Hennnnnnryyyy/StepperController/README.md

# StepperController
A simple handheld stepper controller
