Hennnnnnryyyy/StepperController/Firmware/Stepper_Firmware/Readme.txt

Just open Stepper_Firmware.ino in Arduino IDE. 
Compile it for ESP32S3 Dev Module

Make sure you have the following libraries:
Adafruit_GFX
Adafruit_SSD1305
AccelStepper
TMCStepper
