Hennnnnnryyyy/StepperController/Business Plan.docx

# Summary

Product: Handheld stepper motor controller with knob, buttons, screen; instant jog/reciprocate/constant-speed without writing firmware.

SKUs & MSRP: Base $49; Battery version $89.

Launch path: Kickstarter → Amazon FBA + DTC site, with YouTube dev logs and creator plugs.

Positioning: “The fastest way to move a stepper for debugging and setup—no code, no laptop.”

$28.60 gross/unit; $20.40 net/unit after CAC/ops; break-even 589 units; $90k EBITA @ 5k units, $192k @ 10k.

# Problem → Solution

Problem: Debugging steppers sucks: wiring an MCU, driver, and writing throwaway code just to jog a motor.

Solution: Pocket tool that powers/controls a stepper directly (or via common drivers), with preset modes: jog, constant RPM, reciprocate.

# Product & Roadmap

Base ($49): Controller, USB-C PD, power adapter not included.

Battery ($89): Integrated cell; same UI plus on-the-go use.

Roadmap: Multi-axis, MicroPLC

# Market & Customers

Primary: 3D-printing & CNC hobbyists, R&D labs, robotics teams, test/fixture techs, hardware educators.

Buying triggers: new printer/CNC builds, prototype build involving steppers, prototype testing, troubleshooting jams/skips, fixture bring-up, classroom labs.

# Competitive context

Direct: DIY Arduino + driver; GRBL jog pendants (require controller/firmware); dev boards (uStepper/Mechaduino variants).

Our wedge: zero setup, handheld, purpose-built debugging workflows.

# Go-to-Market

Kickstarter (30–45 days)

Goal: Validate demand + fund tooling/PVT.

Tiers: $44 early bird, $49 regular, $89 battery, 2/3-packs.

Traffic plan: Own YT channel + 5–10 creator plugs; Reddit/Hackaday/Hackster posts; email waitlist.

Post-KS Retail

Amazon FBA: Target 50+ reviews by month 3; keywords around “stepper tester / jog pendant / NEMA17 controller”.

DTC: Simple landing page with demo video and order page; support link & tutorials.

Content cadence: 1 long dev video + 3–5 shorts per month; creator UGC reused as ads.

# Funnel & unit ranges

Assumptions (base):

KS: YT view→click 1.5%; KS page conv 5%; 1.2 units/backer.

Post KS: YT view→click 1%; Amazon page conv 5%; 1.2 units/backer.

Kickstarter units = 297

First year retail = 363

First year total = 660

Optimistic:

Kickstarter units = 3303

First year retail = 4579

First year total = 7579

# Pricing & Unit Economics (non-battery version)

Assumptions: Amazon FBA, referral fee 8% (Consumer Electronics), Trump 40%, heavy social focus CAC.

Ex-Works (China): $8.08

BoM $6.20 • Scrap 3% $0.24 • Direct labor (1.5 min) $0.14 • CM profit $1.00 • Packaging $0.50

Landed Cost (to Amazon): $13.76

Ocean + drayage $2.00 • Tariff 40% $3.14 • Customs/broker/ISF $0.15 • Inbound to Amazon $0.40

Amazon variable fees:

FBA fulfillment $3.43 • Referral (8%) ~$4.00 • Amazon return handling $0.20

Total cost after Amazon fees: $21.39

Unit margins @ $49.99:

Gross profit per unit: $28.60

Below-the-line per-unit: CAC $5.00 • Customer support $0.50 • Inventory financing $1.10 • Returns loss $0.50 • Overhead $1.10

Profit per unit: $20.40

# Financials Summary

Fixed costs: Product liability $1,000, Tooling/fixtures/overhead $10,000, Company overhead $1,000 → Total: $12,000

EBITA by volume (after fixed costs):

Break-even: ~589 units

1,000 units: $8,396.87

2,000 units: $28,793.74

5,000 units: $89,984.35

10,000 units: $191,968.70

# Operations & Timeline (EVT→DVT→PVT)

Now–T0: DFM, finalize schematics/firmware; confirm drivers supported; enclosure tweaks.

T0+4–6 wks: EVT prototypes; bench testing with NEMA 17/23; HAL/EMI pre-checks.

T0+12-16 wks: DVT; pilot run; packaging; KS campaign asset creation.

KS month: 30 days live.

Post-KS (8–12 wks): PVT; ship backer orders; switch listing to Amazon/DTC.

Compliance (can skip for KS):

Base SKU: FCC/CE (unintentional radiator), RoHS.

Battery SKU: UN38.3, MSDS, FBA hazmat eligibility; separate packaging + labeling.

# Key risks & mitigations

Battery logistics (FBA hazmat): start with base SKU first; launch battery on DTC if FBA hazmat queues are slow.

Tariffs/HTS: confirm code; 25% swings landed cost.

Conversion risk: preload reviews via KS backers + Vine; ship with insert card (QR to setup video).

Return rate: target <5% via clear “works with X/Y/Z” compatibility table and wiring diagram.
