Hennnnnnryyyy/StepperController/Money Estimates.xlsx

Sheet: Market Estimation
 | Conservative | Base | Optimistic
KS, 30 days:
YT Viewcount | 50000 | 300000 | 1000000
Other sources (search etc.) | 5000 | 30000 | 100000
YT -> KS funnel | 0.50% | 1.50% | 3.00%
KS conversion | 3% | 5% | 7%
Units per customer | 1.15 | 1.2 | 1.3
Units sold | 9.4875 | 297 | 3003
Post KS
Monthy YT view | 15000 | 50000 | 100000
Other sources (search etc.) | 1500 | 5000 | 100000
YT -> Amazon funnel | 0.30% | 1% | 2%
Product page conversion | 2% | 5% | 8%
Units per customer | 1.15 | 1.2 | 1.3
 | 1.1385 | 33 | 416
First year | 22.011 | 660 | 7579

Sheet: Cost & PL Estimation
Current PCB Design |  |  |  |  |  | Current Pricing |  | Costdown Pricing
Index | Role/Category | Comment | Description | Designator | Quantity | Price @1k | Total @1k | Costdown | Cost down@1k | Total | Notes
25 | Resistors | 10.2k | RES 23.2K OHM 0.5% 1/10W 0603 | R1 | 1 | $0.0005 | $0.001 |  |  | $0.001
26 |  | 470R | RES 23.2K OHM 0.5% 1/10W 0603 | R2 | 1 | $0.0005 | $0.001 |  |  | $0.001
27 |  | 3.9k | RES 23.2K OHM 0.5% 1/10W 0603 | R3 | 1 | $0.0005 | $0.001 |  |  | $0.001
28 |  | 10.5k | RES 23.2K OHM 0.5% 1/10W 0603 | R4 | 1 | $0.0005 | $0.001 |  |  | $0.001
29 |  | 33k | RES 23.2K OHM 0.5% 1/10W 0603 | R5 | 1 | $0.0005 | $0.001 |  |  | $0.001
30 |  | 3.24k | RES 23.2K OHM 0.5% 1/10W 0603 | R6 | 1 | $0.0005 | $0.001 |  |  | $0.001
31 |  | 10k | RES 1% 0603 | R7, R8, R13, R14, R17, R18, R19 | 7 | $0.0005 | $0.004 |  |  | $0.004
32 |  | 47R | RES 1% 0603 | R9, R10, R11, R22, R24, R26, R28, R30, R32, R33, R34 | 11 | $0.0005 | $0.005 |  |  | $0.005
33 |  | 910k | RES 1% 0603 | R12 | 1 | $0.0005 | $0.001 |  |  | $0.001
34 |  | 1k | RES 1% 0603 | R15, R16, R23, R25, R27, R29, R31, R35, R36, R37 | 10 | $0.0005 | $0.005 |  |  | $0.005
35 |  | 100m | C25334 | R20, R21 | 2 | $0.0025 | $0.005 |  |  | $0.005
0 | Capacitors | 100nF | C14663, CAP CER 0.022UF 25V X7R 0603 | C1, C4, C6, C14, C15, C18, C19, C22, C24, C25, C27, C28, C32, C33, C34, C35, C36, C37, C38, C39, C40, C42 | 22 | $0.0014 | $0.03 |  |  | $0.03
1 |  | 22uF | C12891 | C2, C3 | 2 | $0.0270 | $0.05 |  |  | $0.05
2 |  | 1uF | CAP CER 0.022UF 25V X7R 0603, C15849 | C5, C13, C16, C20 | 4 | $0.0027 | $0.01 |  |  | $0.01
3 |  | 10uF | C13585, C89632 | C7, C8, C12, C21, C23 | 5 | $0.0189 | $0.09 |  |  | $0.09
4 |  | 8.2nF |  | C9 | 1 | $0.0108 | $0.01 |  |  | $0.01
5 |  | 10pF |  | C10 | 1 | $0.0108 | $0.01 |  |  | $0.01
6 |  | 3.3nF |  | C11 | 1 | $0.0108 | $0.01 |  |  | $0.01
7 |  | 4.7uF | C29823 | C17 | 1 | $0.0197 | $0.02 |  |  | $0.02
8 |  | 100uF | C445063 | C29, C41 | 2 | $0.1334 | $0.27 | VEJ101M1HTR-0810 | $0.0508 | $0.10 | Cheap caps but not the worst caps
9 |  | 22nF | C21122 | C30 | 1 | $0.0025 | $0.0025 |  |  | $0.0025
10 |  | 2.2uF | C23630 | C31 | 1 | $0.0033 | $0.0033 |  |  | $0.0033
15 | Signals Out Terminal | Black | C430602 | E2 | 1 | $0.1648 | $0.16 |  | $0.0000 | $0.00 | Only one terminal set
20 | USB Conn. for Programming | 670688000 | Connector | J3 | 1 | $0.6645 | $0.66 |  | $0.0000 | $0.00 | No USB programming
39 | USB - UART converter | CP2102-GMR | Single-Chip USB to URAT Bridge, 3.3 V, -40 to 85 degC, 28-Pin QFN, RoHS, Tape and Reel | U3 | 1 | $1.2990 | $1.30 |  | $0.0000 | $0.00 | No USB programming
13 | Indicator | RED LED | 0603 LED | DS1 | 1 | $0.0107 | $0.01 |  |  | $0.01
24 | USB-UART reset transistors | MMBT5551LT1G | C41095 | Q1, Q2 | 2 | $0.0108 | $0.02 |  | $0.0000 | $0.00
23 | Other Motor Plugs | 22-27-2041 | C504991 | P1, P2 | 2 | $0.2560 | $0.51 | C22438287 | $0.0111 | $0.02
18 | DC Power Jack | DC-005-5A-2.0-SMT | C319134 | J1 | 1 | $0.2325 | $0.23 | USB-C | $0.0300 | $0.03 |  | https://www.lcsc.com/product-image/C29780875.html
17 | MCU | ESP32-S3-WROOM-1 | Integrated Circuit | IC1 | 1 | $3.4500 | $3.45 | STM32F030C6T6TR | $0.3645 | $0.36 | Not decided, just placeholder MCU | https://www.lcsc.com/product-detail/C106925.html?s_z=n_STM32F030C6T6TR
11 | Protection Diode | SS54 | SS54 | D1 | 1 | $0.0359 | $0.04 |  |  | $0.04
22 | Inductor | 22uH | C2651173 | L1 | 1 | $0.0483 | $0.05 |  |  | $0.05
19 | OLED Flex Connector | AFC07-S24ECA-00 | C262643 | J2 | 1 | $0.0569 | $0.06 |  |  | $0.06
38 | 12V Regulator for OLED | LM317AG-TN3-R | C75510 | U2 | 1 | $0.0912 | $0.09 |  |  | $0.09
37 | 3v3 Regulator | TPS54231DR | Buck Step Down Regulator with 3.5 to 28 V Input and 0.8 to 25 V Output, -40 to 150 degC, 8-Pin SOIC (D), Green (RoHS & no Sb/Br) | U1 | 1 | $0.1130 | $0.11 |  |  | $0.11
12 | TVS Diodes | 3V | C12756 | D2, D3, D4 | 3 | $0.0402 | $0.12 |  |  | $0.12
36 | Buttons | C255812 | SWITCH TACTILE SPST-NO 0.05A 24V | SW1, SW2, SW3, SW4, SW5, SW6, SW7 | 7 | $0.0201 | $0.14 |  |  | $0.14
14 | Power Out Terminals | Orange | C430604 | E1 | 1 | $0.1494 | $0.15 |  |  | $0.15
40 | Stepper Driver IC | TMC2209-LA | C465949 | U4 | 1 | $1.4535 | $1.45 | Custom | $0.2000 | $0.20 | Cost down stepper driver with external FETs
16 | Rotary Encoder | PEC11L-4115F-S0020 | ROTARY ENCODER MECHANICAL 20PPR | ENC1 | 1 | $2.0000 | $2.00 |  | $0.4000 | $0.40 | Costdown encoder
21 | Motor Spring Connections | XY115A-5.0-2P | C784935 | J4, J5 | 2 | $0.2114 | $0.42 |  | $0.0700 | $0.14 | Different connector | https://www.lcsc.com/product-image/C5349564.html
41 |  | PCB Substrate 120x70 |  |  | 1 | $0.4270 | $0.43 |  |  | $0.43
 |  | PCB Assembly Cost |  |  | 1 | $2.0000 | $2.00 |  |  | $1.00 | Guess
 |  | OLED |  |  | 1 | $7.0000 | $7.00 |  | $1.8000 | $1.80 | OLED doesn't seem to be affected by MOQ too much. $2 LCD
 |  | Shell | 36 grams ABS |  | 1 | $0.6000 | $0.60 |  |  | $0.60
 |  | Knob | 3gram ABS |  | 1 | $0.1000 | $0.10 |  |  | $0.10
 |  | BoM total |  |  |  |  | $21.65 |  |  | $6.22
 |  | Scrap | 3% |  |  |  |  |  |  | $0.24
 |  | Direct labor | 1.5 min assembly, test, box |  |  |  |  |  |  | $0.14
 |  | CM profit |  |  |  |  |  |  |  | $1.00
 |  | Packaging | Box |  | 1 | $0.5000 | $0.50 |  |  | $0.50
 |  | Ex-Works |  |  |  |  |  |  |  | $8.10
 |  | Ocean frieght + domistic drayage |  |  |  |  |  |  |  | $2.00
 |  | Trump | 40% |  |  |  |  |  |  | $3.15
 |  | Customs fees, brokerage, ISF |  |  |  |  |  |  |  | $0.15
 |  | Inbound to Amazon |  |  |  |  |  |  |  | $0.40
 |  | Landed cost |  |  |  |  |  |  |  | $13.80
 |  | FBA fulfilment |  |  |  |  |  |  |  | $3.43 | Simlar rates for KS
 |  | Referral Fee (consumer electronics) | 8% sell price, absorbs credit card fees here |  |  |  |  |  |  | $4.00
 |  | Returns |  |  |  |  |  |  |  | $0.20
 |  | Total Cost after Amazon Fees |  |  |  |  |  |  |  | $21.43
 |  | Retail price (set here) |  |  |  |  |  |  |  | $49.99
 |  | Gross profit per unit |  |  |  |  |  |  |  | $28.56
 |  | CAC/unit | Marketing, sample units, heavy social media focus |  |  |  |  |  |  | -$5.00
 |  | Customer service | Discord moderator |  |  |  |  |  |  | -$0.50
 |  | Inventory |  |  |  |  |  |  |  | -$1.10
 |  | Returns |  |  |  |  |  |  |  | -$0.50
 |  | Overhead |  |  |  |  |  |  |  | -$1.10
 |  | Net profit per unit |  |  |  |  |  |  |  | $20.36
 |  | Fixed costs
 |  | Product liability insurance |  |  |  |  |  |  |  | -$1000.00
 |  | Tool cost + setup fees + overhead (conservative) |  |  |  |  |  |  |  | -$10000.00
 |  | Company overhead |  |  |  |  |  |  |  | -$1000.00
 |  | Total fixed costs |  |  |  |  |  |  |  | -$12000.00
 |  |  |  |  |  |  |  |  | Units sold | EBITA
 |  |  |  |  |  |  |  |  | 589 | -$6.49
 |  |  |  |  |  |  |  |  | 1000 | $8362.50
 |  |  |  |  |  |  |  |  | 2000 | $28725.00
 |  |  |  |  |  |  |  |  | 5000 | $89812.50
 |  |  |  |  |  |  |  |  | 10000 | $191625.00
 |  |  |  |  |  |  |  |  | 20000 | $395250.00
 |  |  |  |  |  |  |  |  | 50773 | $1021865.21
