Hennnnnnryyyy/StepperController/CAD/Housing.step

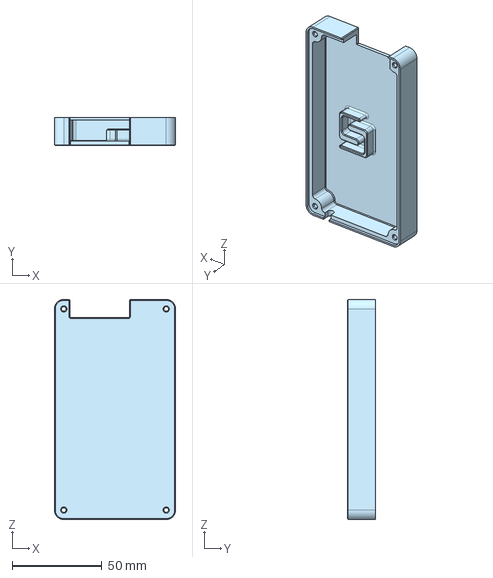
[picture p1: CAD file, 2025-09-03]
CAD/Housing.step
67.5 x 15.8 x 122.5 mm
