Hennnnnnryyyy/StepperController/PCB/KiCAD/Library Files/EC12D1524403/3D/EC12D1524403.stp

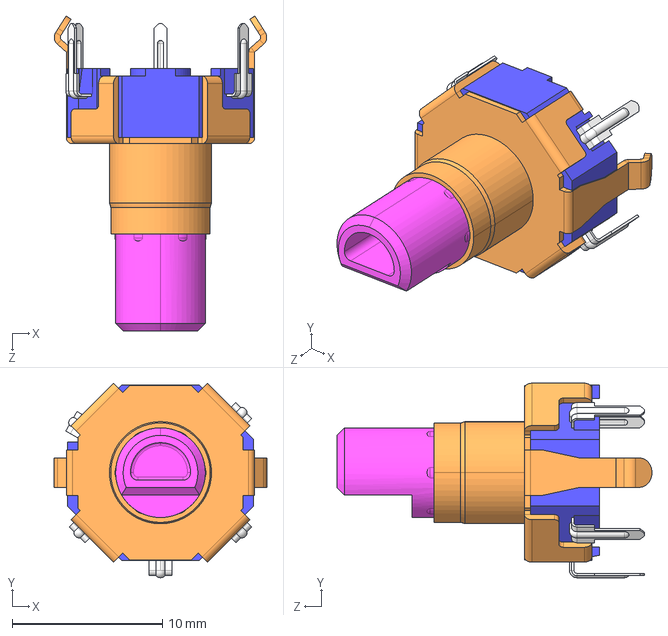
[picture p2: CAD file, 2025-09-03]
PCB/KiCAD/Library Files/EC12D1524403/3D/EC12D1524403.stp
14.1 x 13.0 x 21.0 mm
