Hennnnnnryyyy/StepperController/CAD/Knob.step

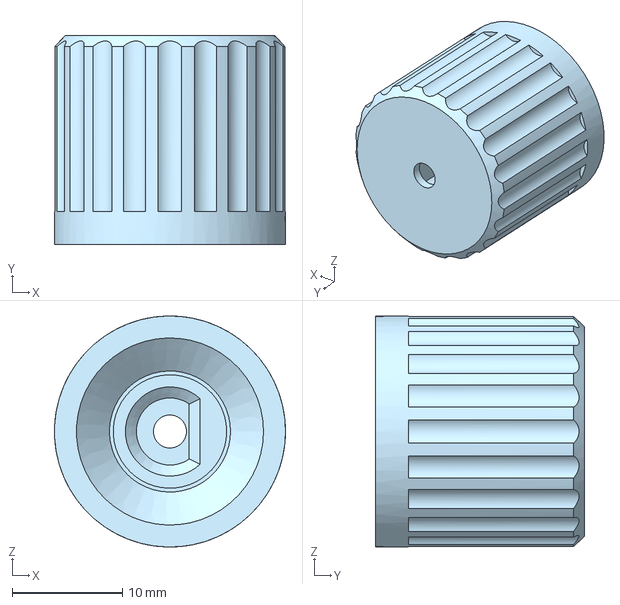
[picture p3: CAD file, 2025-09-03]
CAD/Knob.step
21.0 x 19.0 x 21.0 mm
