Hennnnnnryyyy/StepperController/(list of files, cad)

Other CAD files:
PCB/KiCAD/Library Files/EC12D1524403/Allegro/ec12d1524403.psm
PCB/KiCAD/Library Files/EC12D1524403/DEHDL/ec12d1524403/chips/chips.prt
