Hennnnnnryyyy/StepperController/PCB/Schematic.PDF

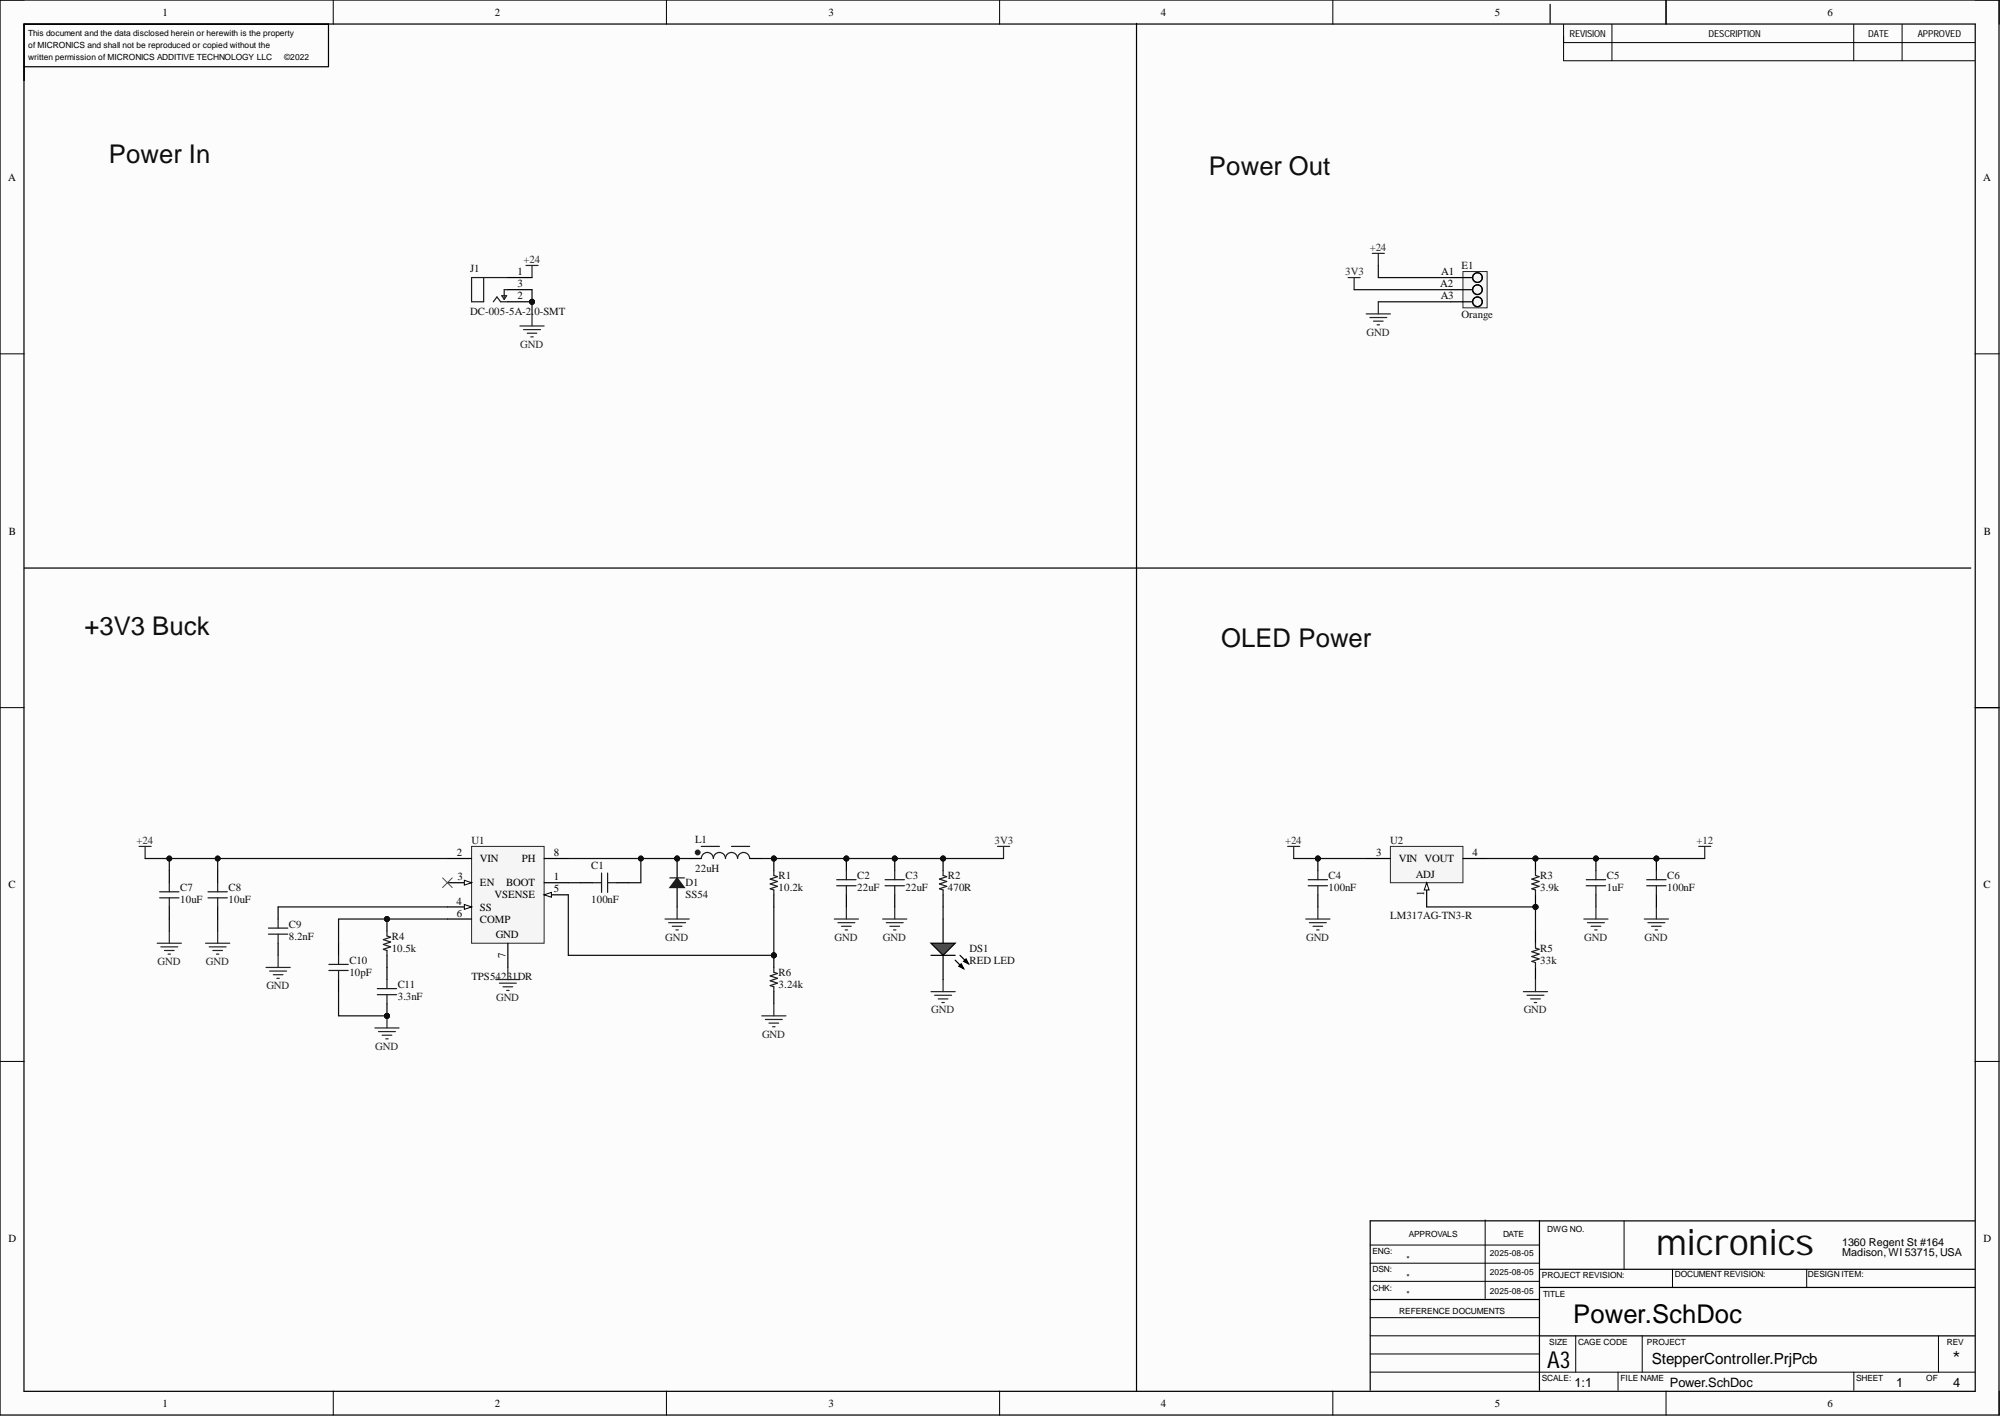
[picture p4: page 1]

This document and the data disclosed herein or herewith is the property
of MICRONICS and shall not be reproduced or copied without the

APPROVALS | DATE | DWG NO. | micronics 1360 Regent St #164 Madison, WI 53715, USA

ENG: * | 2025-08-05

DSN: * | 2025-08-05

CHK: * | 2025-08-05

SIZE A3 | CAGE CODE | PROJECT StepperController.PrjPcb | REV

SCALE: 1:1 | FILE NAME Power.SchDoc | SHEET 1 OF

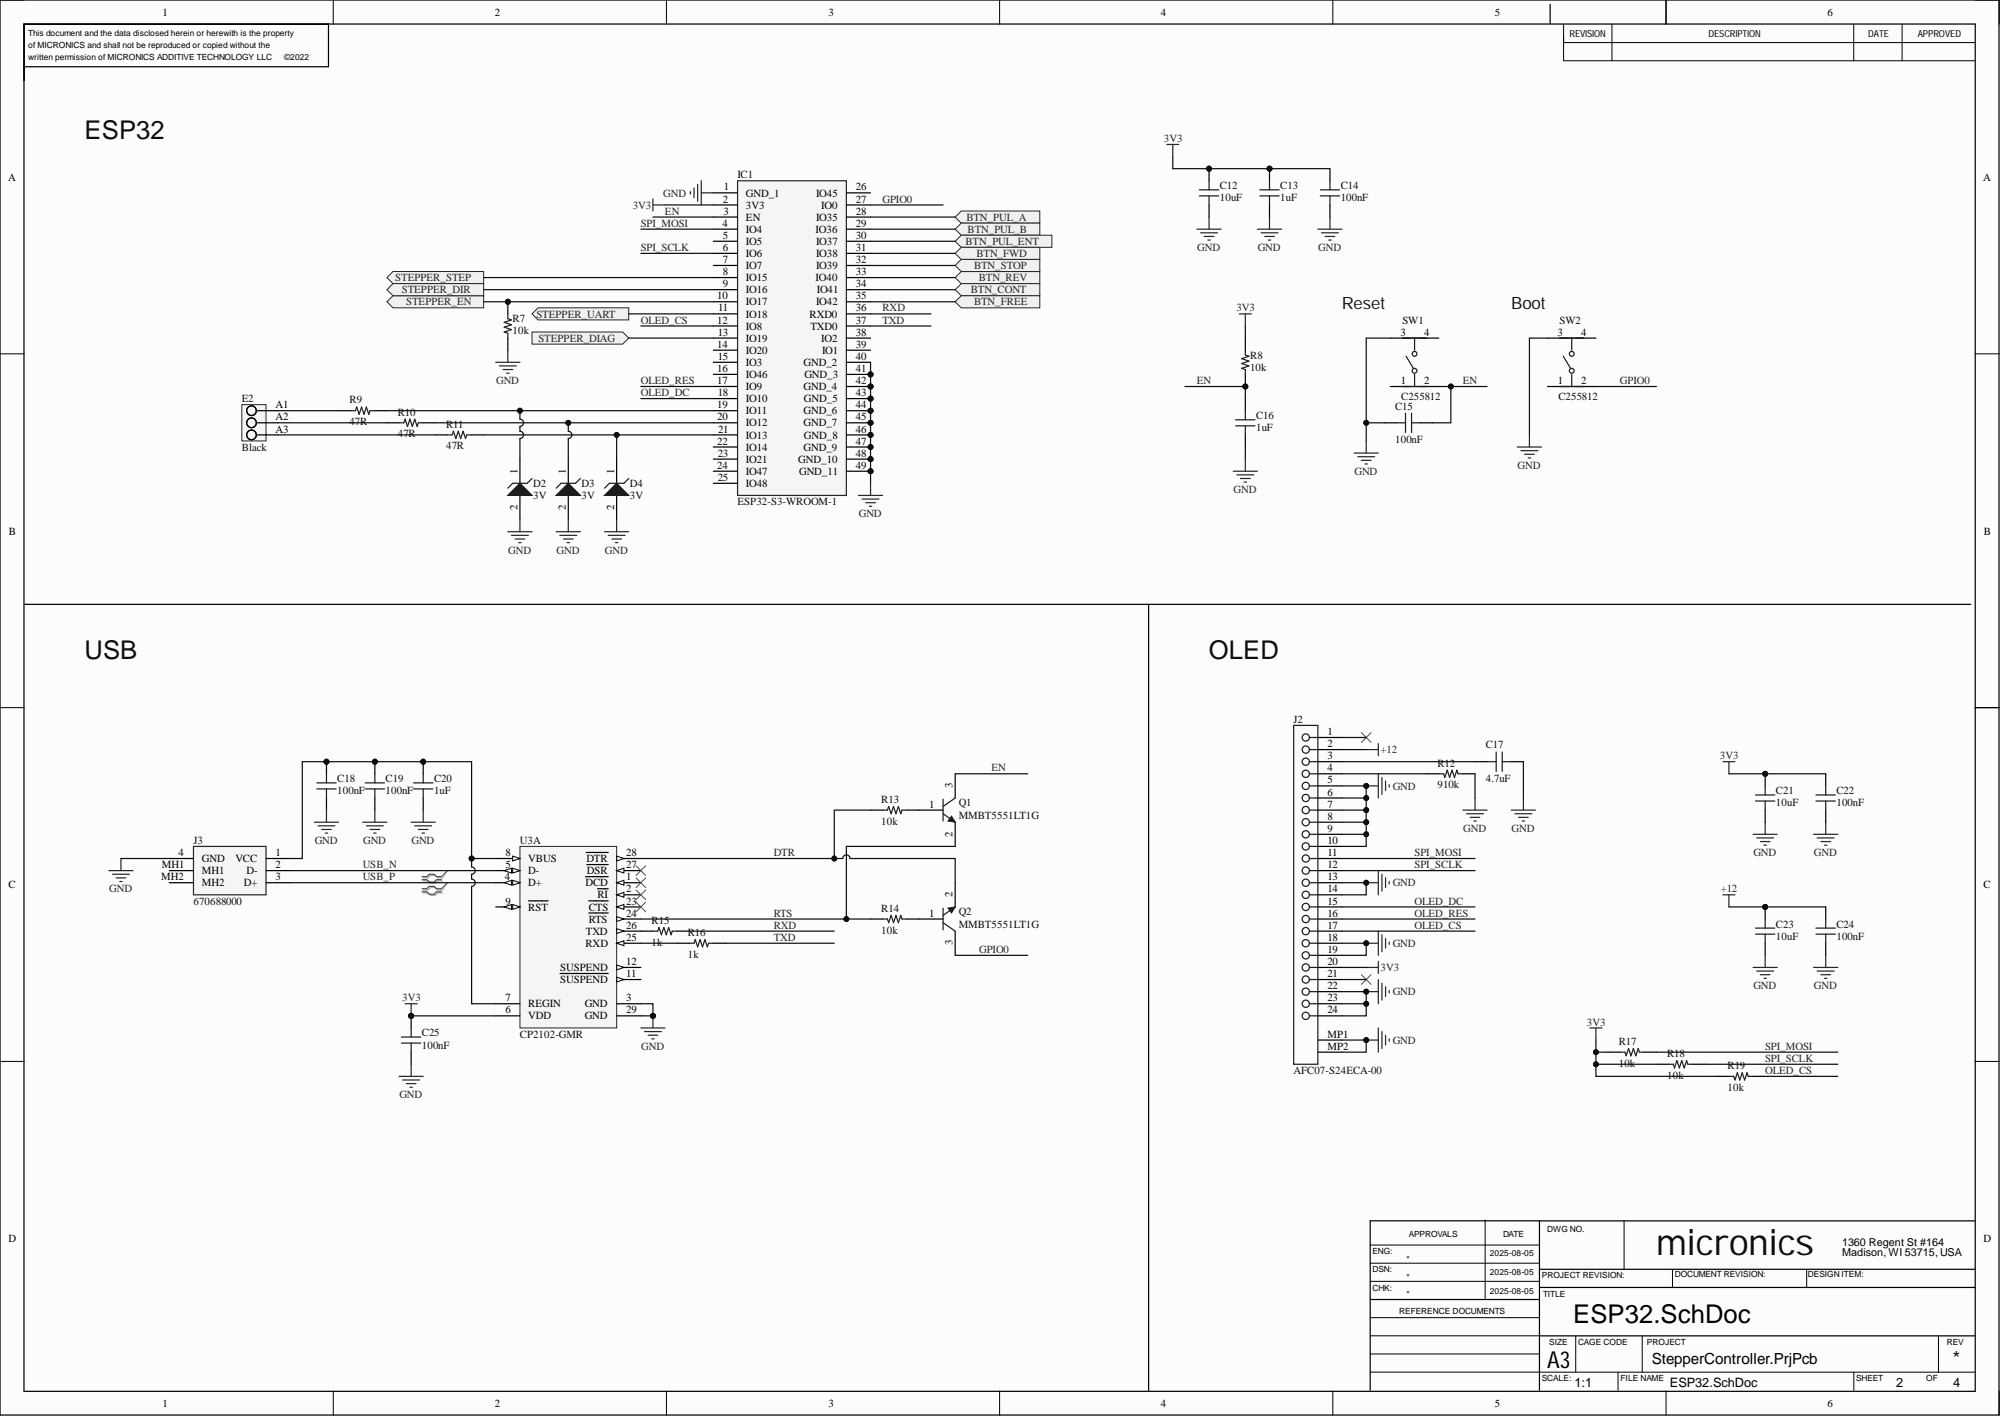
[picture p5: page 2]

APPROVALS | DATE | DWG NO. | micronics 1360 Regent St #164 Madison, WI 53715, USA

ENG: * | 2025-08-05

DSN: * | 2025-08-05

CHK: | 2025-08-05

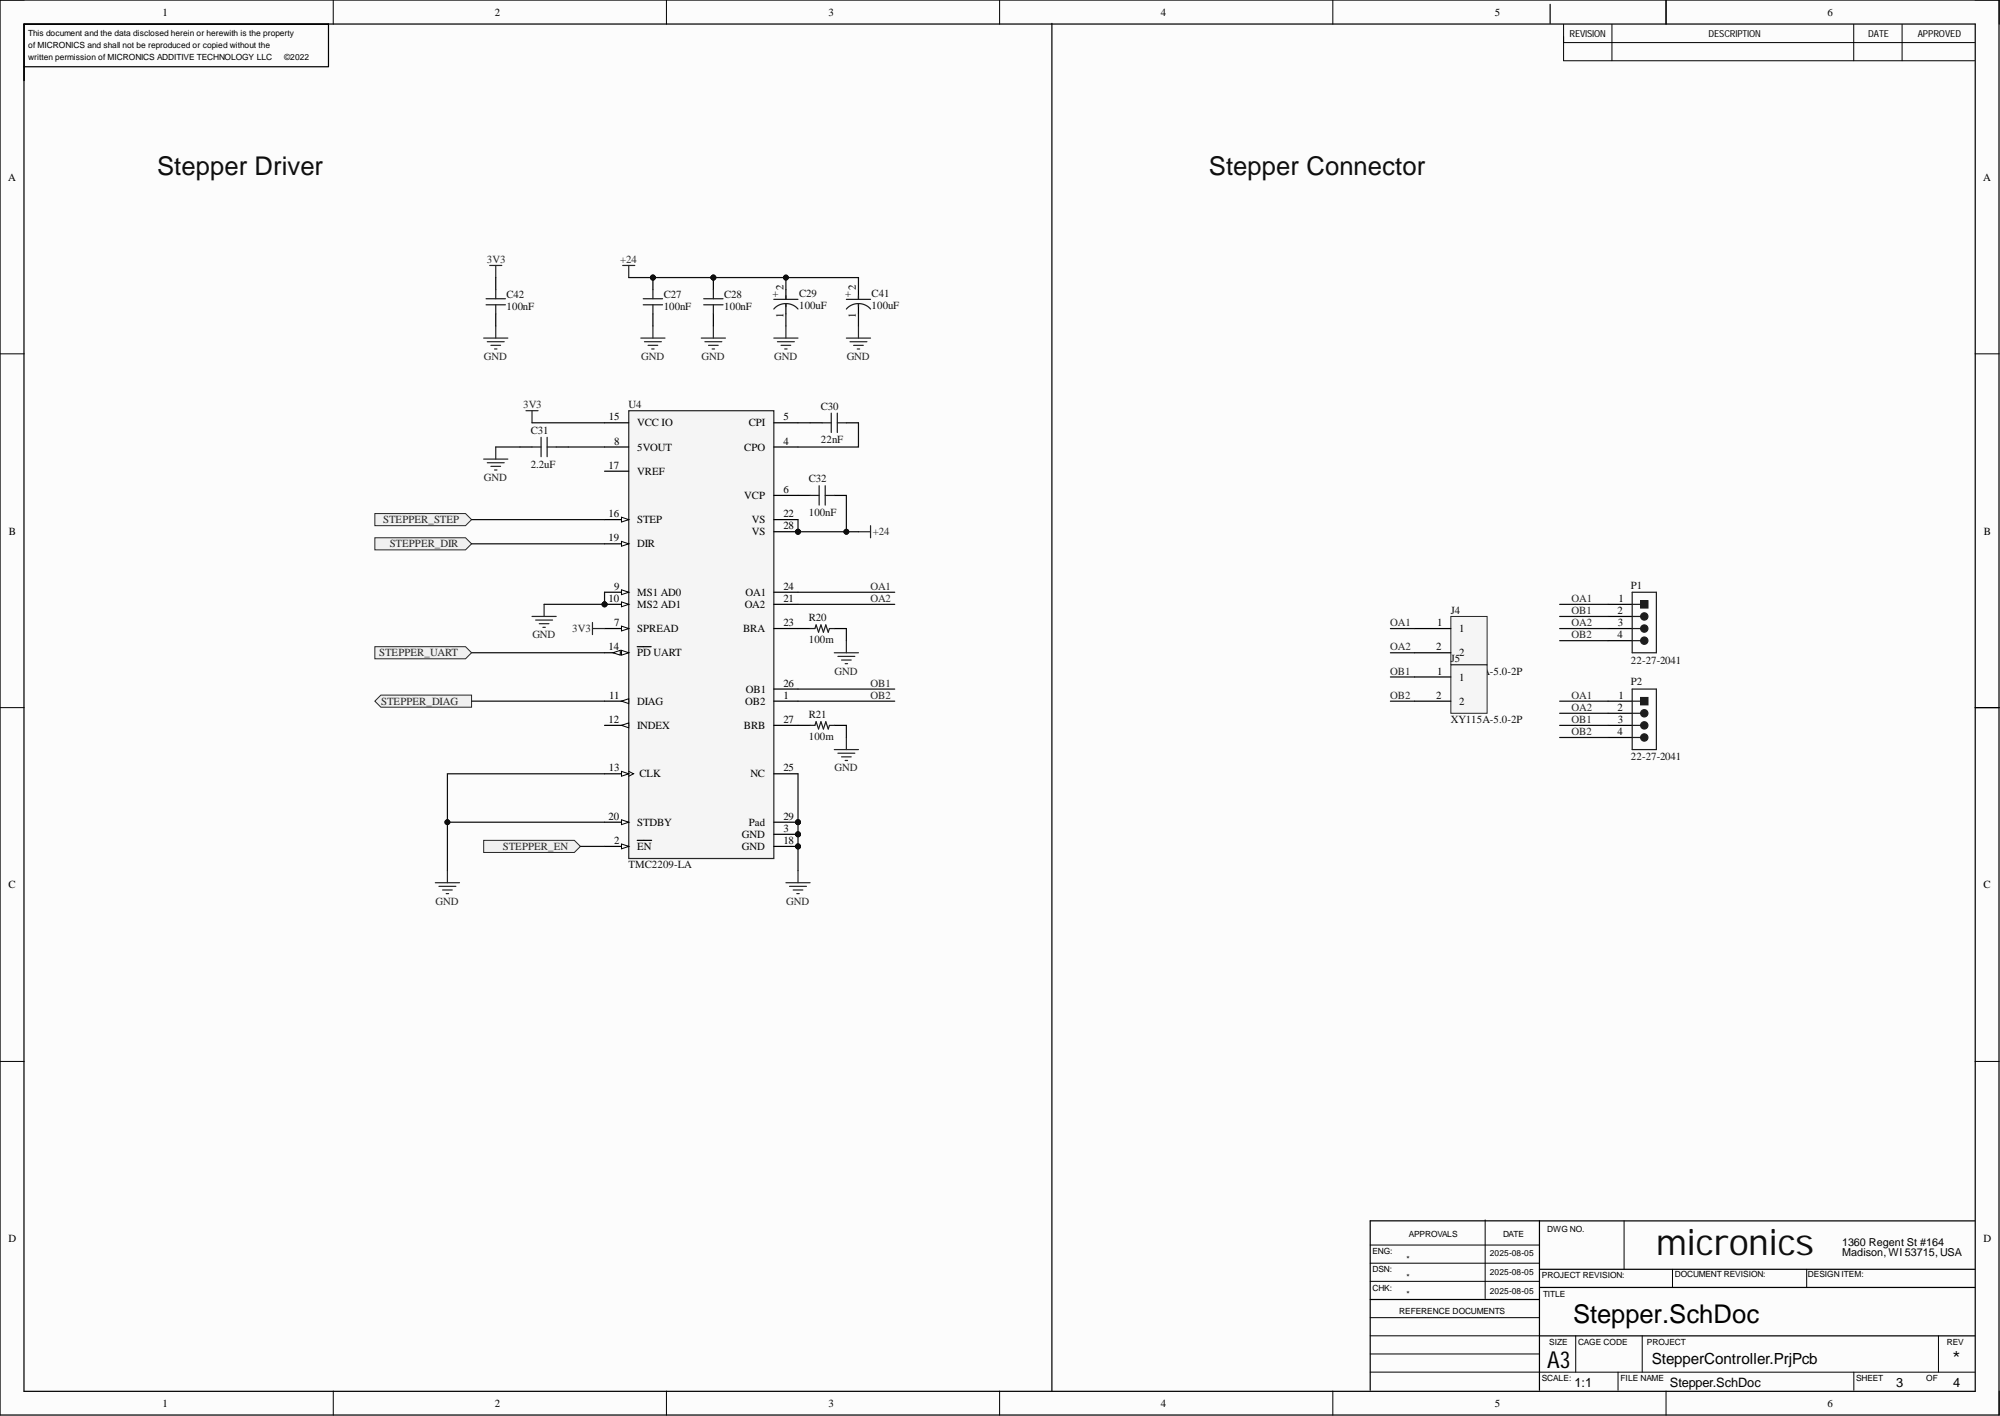
[picture p6: page 3]

STDBY 20

STEPPER_EN | EN 2

APPROVALS | DATE | DWG NO. | micronics 1360 Regent St #164 Madison, WI 53715, USA

ENG: * | 2025-08-05

DSN: * | 2025-08-05

CHK: | 2025-08-05

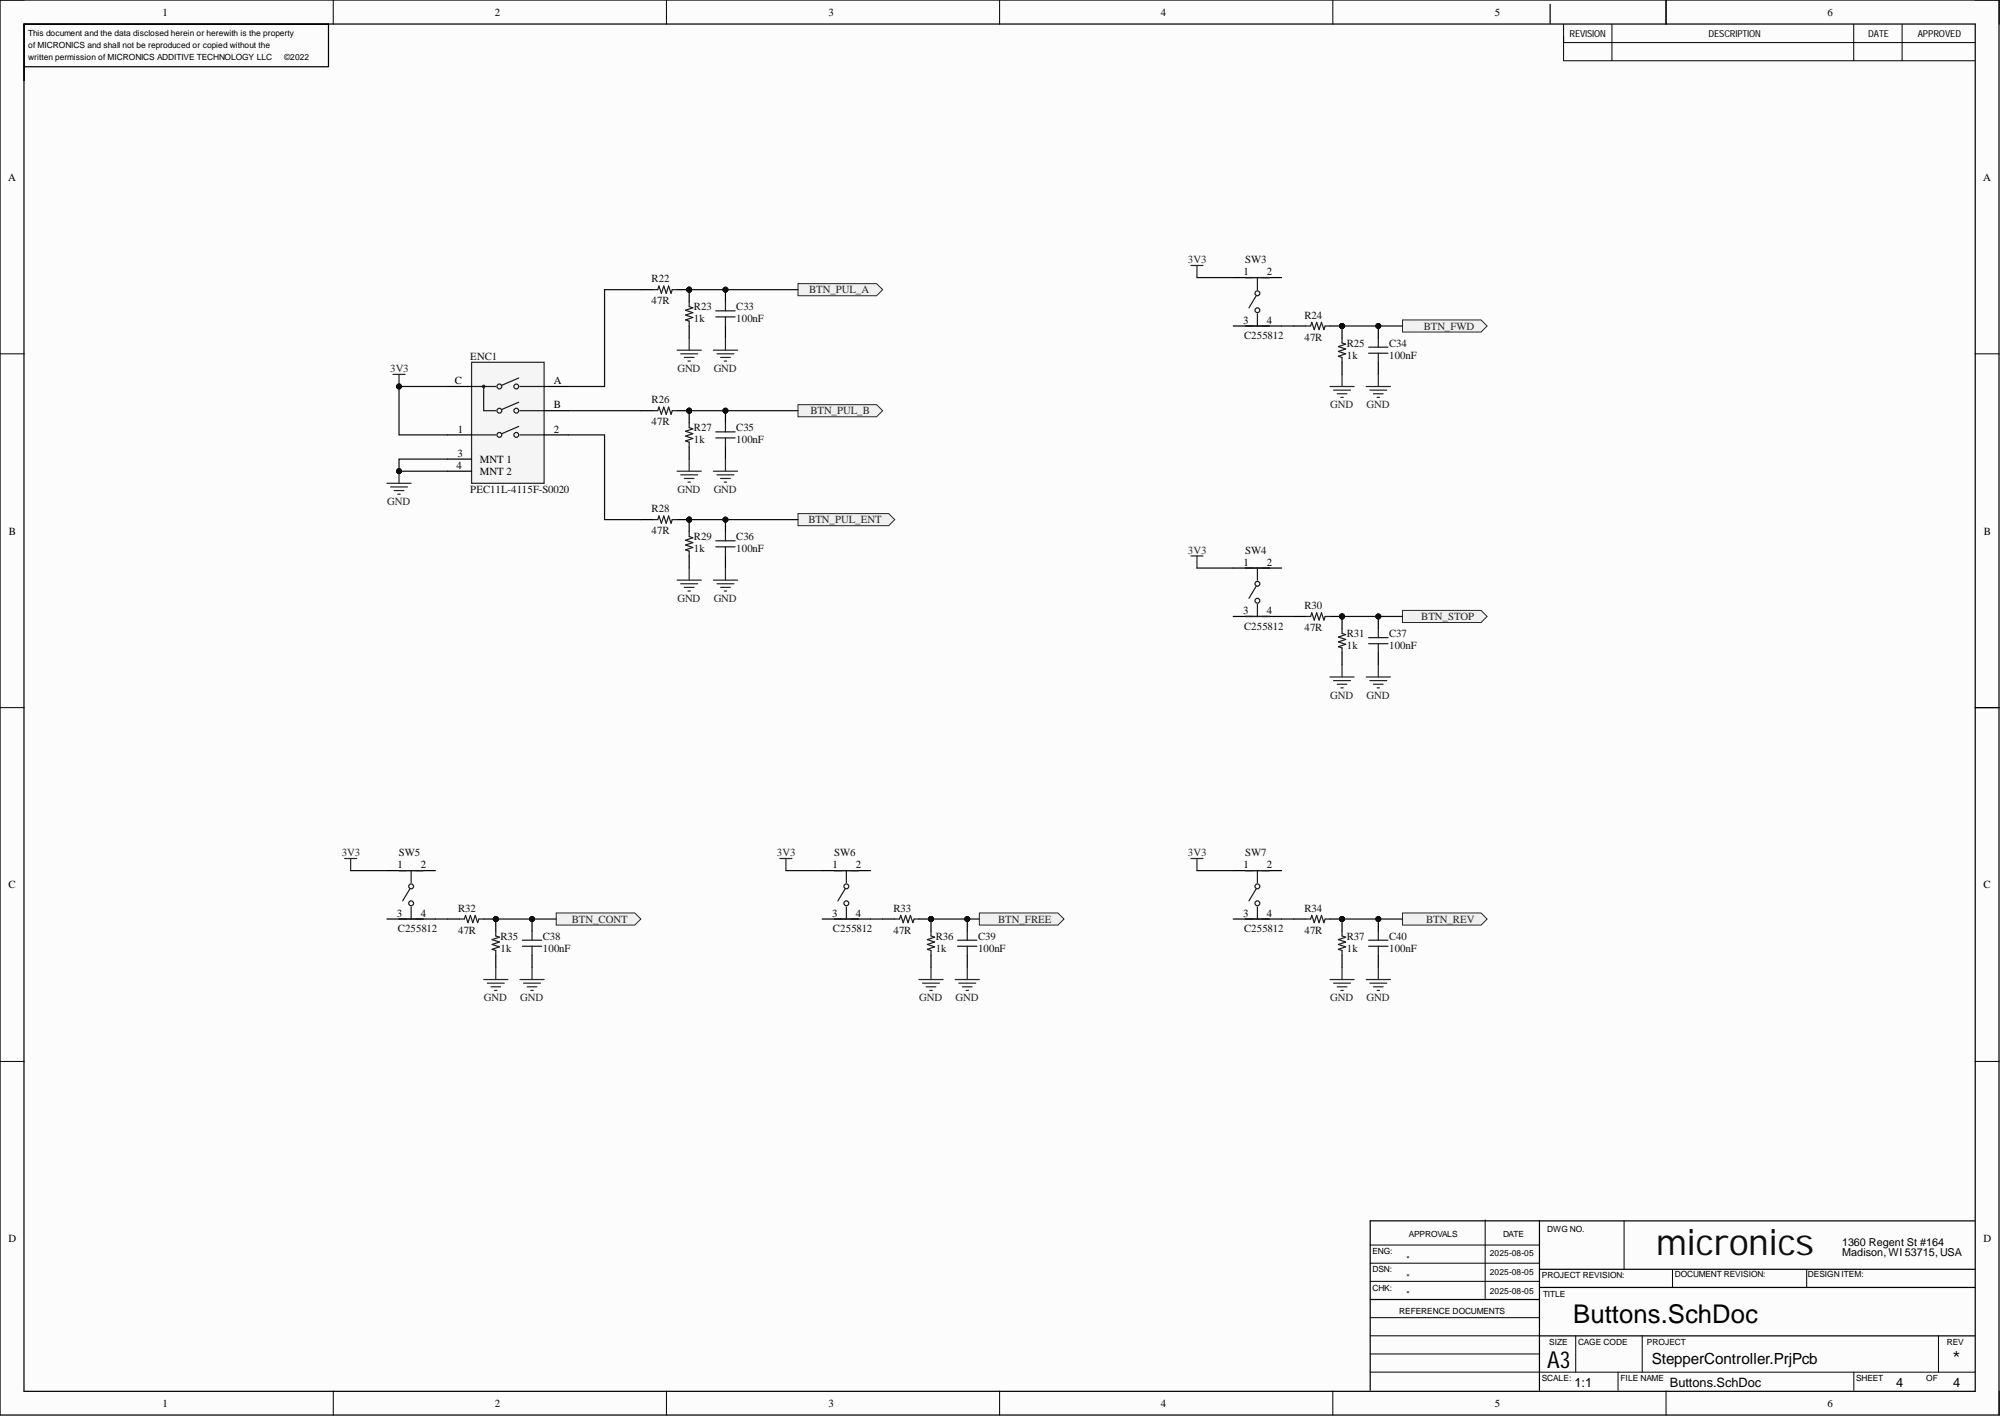
[picture p7: page 4]

APPROVALS | DATE | DWG NO. | micronics 1360 Regent St #164 Madison, WI 53715, USA

ENG: * | 2025-08-05

DSN: * | 2025-08-05

CHK: | 2025-08-05
