Hennnnnnryyyy/StepperController/(list of files, drawings)

Other design files:
PCB/KiCAD/Library Files/EC12D1524403/Altium/EC12D1524403.PcbLib
PCB/KiCAD/Library Files/EC12D1524403/Altium/EC12D1524403.SchLib
PCB/StepperController/Buttons.SchDoc
PCB/StepperController/ESP32.SchDoc
PCB/StepperController/Power.SchDoc
PCB/StepperController/Stepper.SchDoc
PCB/StepperController/StepperController.PrjPcb
