Hennnnnnryyyy/StepperController/PCB/KiCAD/StepperControllerPCB.kicad_pcb

## KiCad design PCB/KiCAD/StepperControllerPCB.kicad_pcb (2025-09-20)

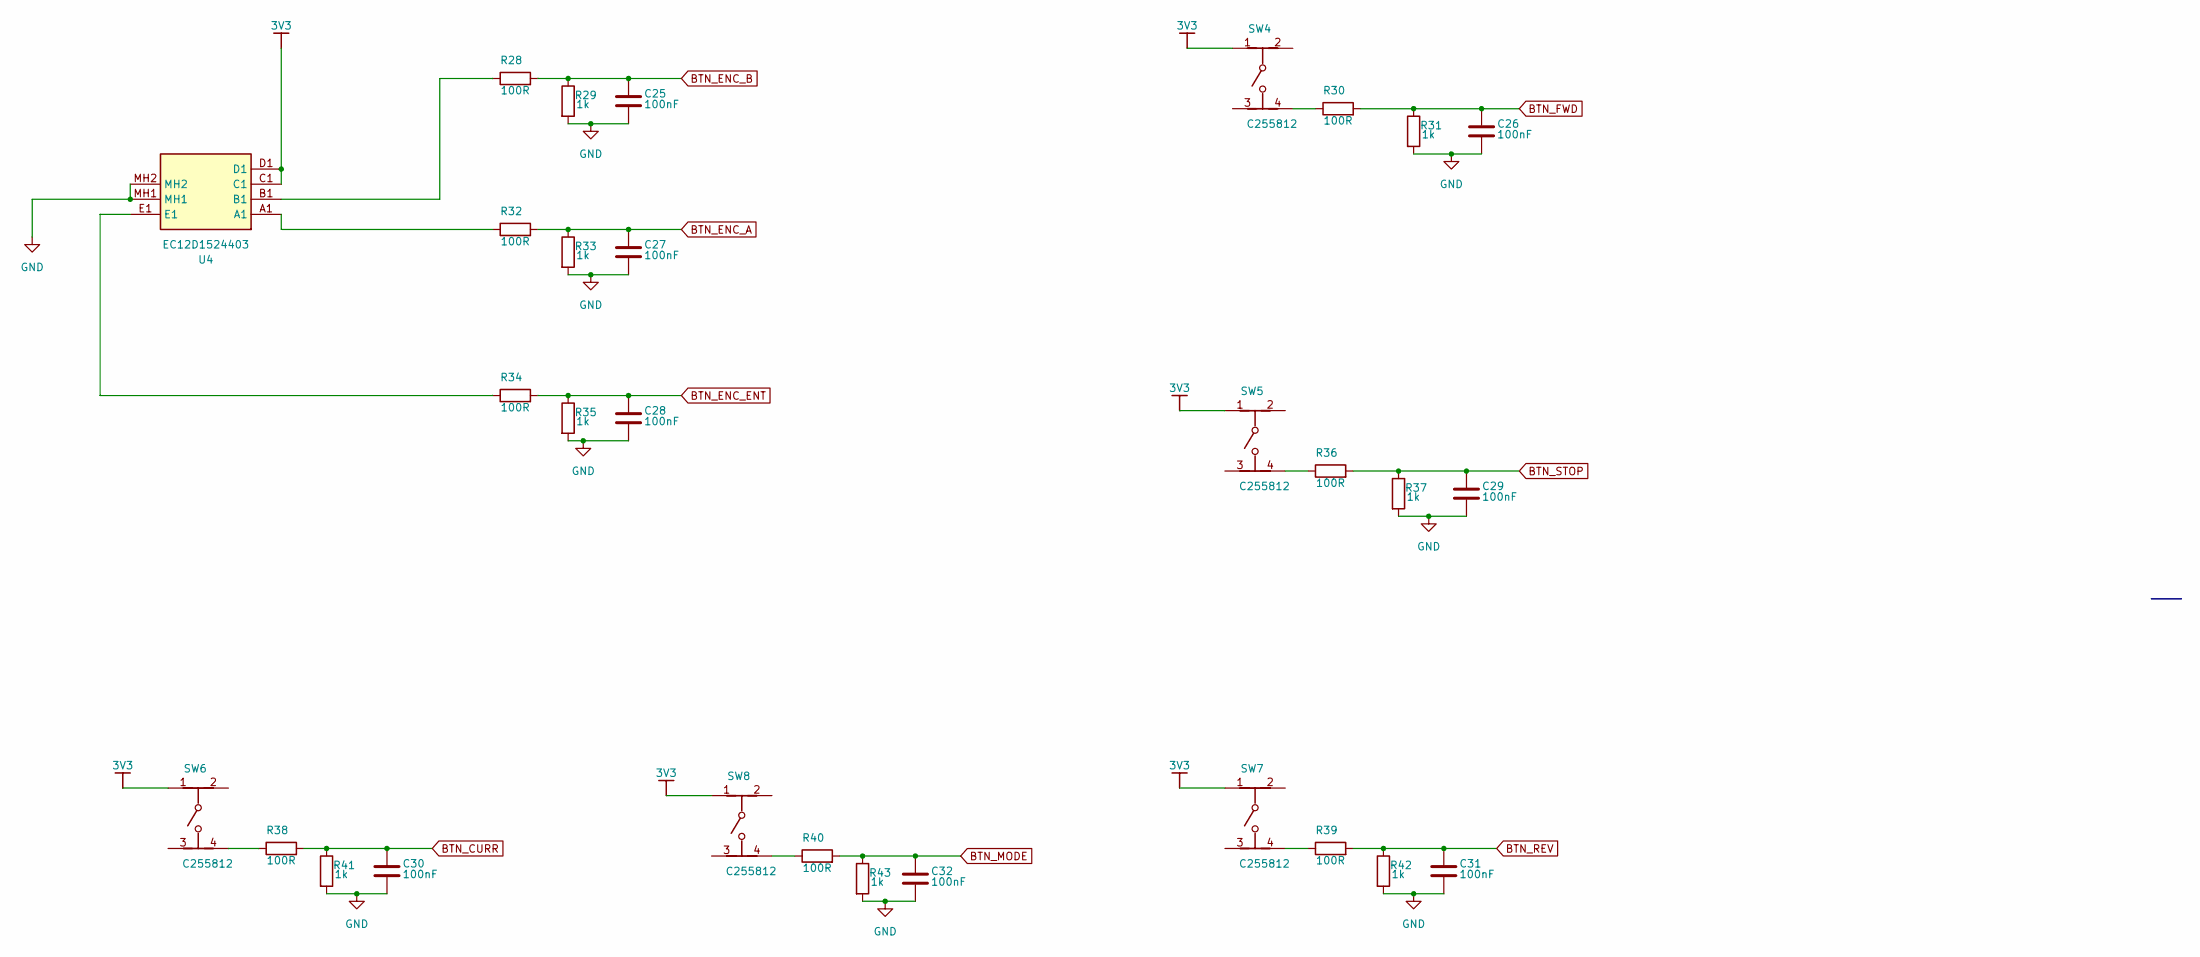
[picture p8: schematic Buttons.kicad_sch]

Parts:
C25, C26, C27, C28, C29, C30, C31, C32: 100nF; C_0603_1608Metric
R28, R30, R32, R34, R36, R38, R39, R40: 100R; R_0603_1608Metric
R29, R31, R33, R35, R37, R41, R42, R43: 1k; R_0603_1608Metric
SW4, SW5, SW6, SW7, SW8: C255812; FSM2J_1; VOLTAGE RATING DC 24V; MANUFACTURER PART NUMBER FSM2JSMAA; MOUSER DESCRIPTION Tactile Switches TACTILE 260G FORCE S
U4: EC12D1524403; Mouser Part Number 688-EC12D1524403

Connections:
3V3: SW4.1, SW5.1, SW6.1, SW7.1, SW8.1, U4.C1, U4.D1; also elsewhere on the board
BTN_CURR: C30.1, R38.2, R41.1; also elsewhere on the board
BTN_ENC_A: C27.1, R32.2, R33.1; also elsewhere on the board
BTN_ENC_B: C25.1, R28.2, R29.1; also elsewhere on the board
BTN_ENC_ENT: C28.1, R34.2, R35.1; also elsewhere on the board
BTN_FWD: C26.1, R30.2, R31.1; also elsewhere on the board
BTN_MODE: C32.1, R40.2, R43.1; also elsewhere on the board
BTN_REV: C31.1, R39.2, R42.1; also elsewhere on the board
BTN_STOP: C29.1, R36.2, R37.1; also elsewhere on the board
GND: C25.2, C26.2, C27.2, C28.2, C29.2, C30.2, C31.2, C32.2, R29.2, R31.2, R33.2, R35.2, R37.2, R41.2, R42.2, R43.2, U4.MH1, U4.MH2; also elsewhere on the board
unnamed: R28.1, U4.B1
unnamed: R30.1, SW4.4
unnamed: R32.1, U4.A1
unnamed: R34.1, U4.E1
unnamed: R36.1, SW5.4
unnamed: R38.1, SW6.4
unnamed: R39.1, SW7.4
unnamed: R40.1, SW8.4

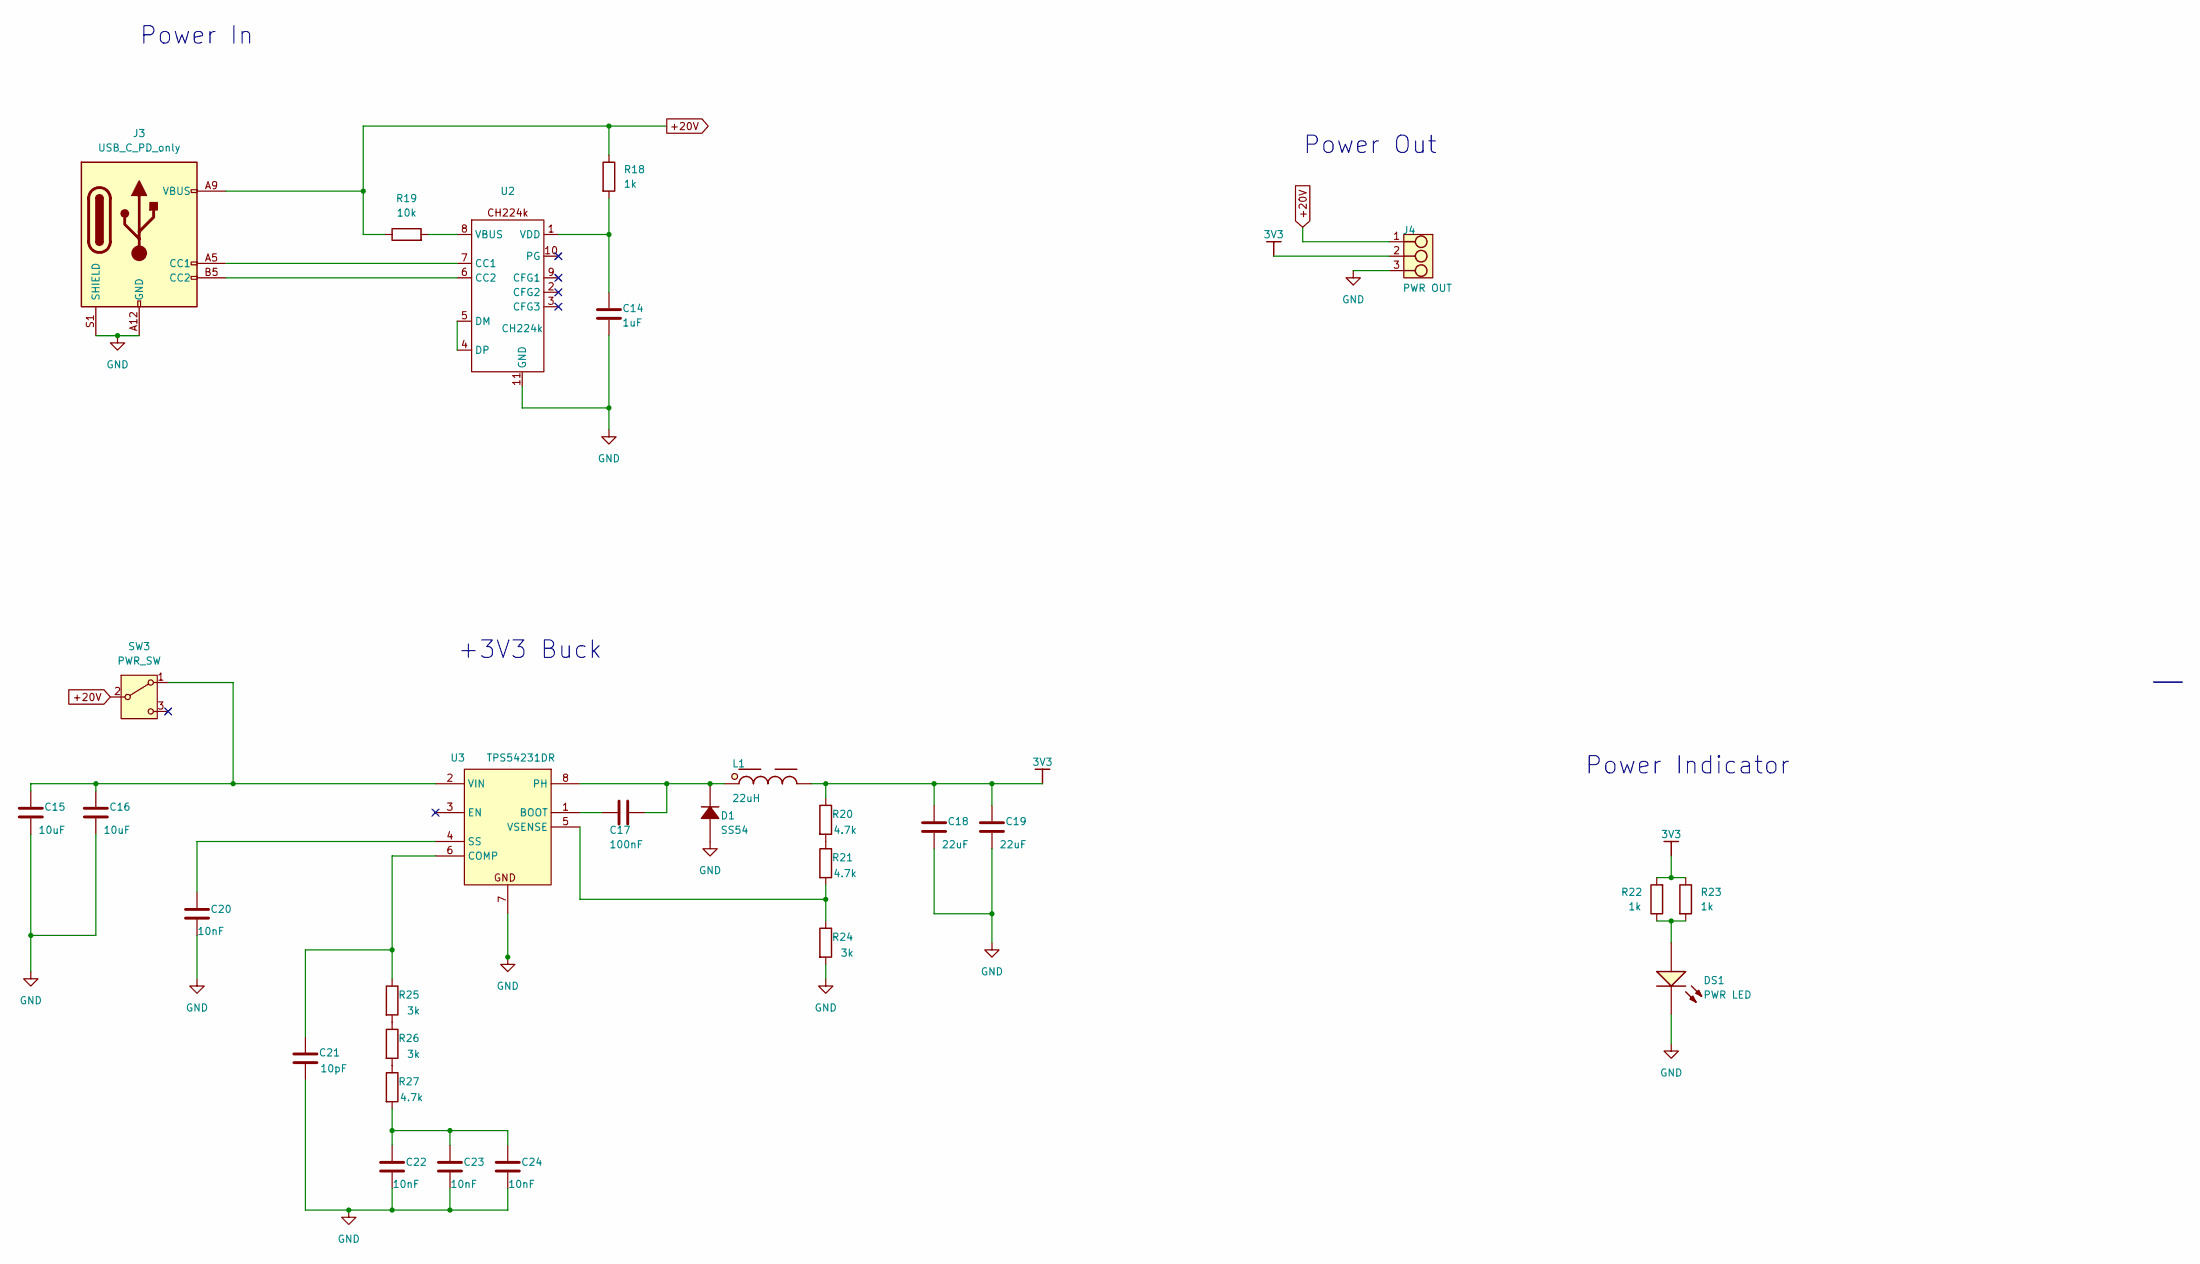
[picture p9: schematic Power.kicad_sch]

Parts:
C14: 1uF; C_0603_1608Metric; TOLERANCE ±20%; VOLTAGE - RATED 25V; PART NUMBER 250X14W223MV4T
C15, C16: 10uF; C_1206_3216Metric
C17: 100nF; C_0603_1608Metric
C18, C19: 22uF; C_1206_3216Metric
C20, C22, C23, C24: 10nF; C_0603_1608Metric
C21: 10pF; C_0603_1608Metric
D1: SS54; D_SMA; VOLTAGE - DC REVERSE (V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 50V; VOLTAGE - FORWARD (VF) 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 1.3V @ 1A; PART NUMBER SS54; LCSC C22452
DS1: PWR LED; LED_1206_3216Metric; FORWARD VOLTAGE 1.8V; LCSC C84270
J3: USB_C_PD_only; USB_C_Receptacle_GCT_USB4125-xx-x_6P_TopMnt_Horizontal; LCSC C18357551
J4: PWR OUT; TerminalBlock_RND_205-00288_1x03_P5.08mm_Horizontal; PARTNUMBER 1760500000; LCSC C430602
L1: 22uH; SMDRH105R; INDUCTANCE TOLERANCE 20%; TOLERANCE 20%; LCSC C10165
R18, R22, R23: 1k; R_0603_1608Metric
R19: 10k; R_0603_1608Metric
R20, R21, R27: 4.7k; R_0603_1608Metric
R24, R25, R26: 3k; R_0603_1608Metric
SW3: PWR_SW; Swtich SS-12F44-G5; LCSC C136718
U2: CH224k; SSOP-10_3.9x4.9mm_P1.00mm; LCSC C970725
U3: TPS54231DR; SOIC-8_3.9x4.9mm_P1.27mm; RATING Catalog; PARTNUMBER TPS54231DR; LCSC C28023

Connections:
3V3: C18.1, C19.1, J4.2 (A2), L1.2, R20.1, R22.2, R23.1; also elsewhere on the board
+20V: J3.A9 (VBUS), J3.B9 (VBUS), J4.1 (A1), R18.1, R19.1, SW3.2 (B); also elsewhere on the board
GND: C14.2, C15.2, C16.2, C18.2, C19.2, C20.2, C21.2, C22.2, C23.2, C24.2, D1.1, DS1.2 (K), J3.A12 (GND), J3.B12 (GND), J3.S1 (SHIELD), J4.3 (A3), R24.2, U2.11 (GND), U3.7 (GND); also elsewhere on the board
unnamed: C22.1, C23.1, C24.1, R27.2
unnamed: DS1.1 (A), R22.1, R23.2
unnamed: J3.A5 (CC1), U2.7 (CC1)
unnamed: J3.B5 (CC2), U2.6 (CC2)
unnamed: R20.2, R21.1
unnamed: R25.2, R26.1
unnamed: R26.2, R27.1
unnamed: C15.1, C16.1, SW3.1 (A), U3.2 (VIN)
unnamed: U2.4 (DP), U2.5 (DM)
unnamed: R19.2, U2.8 (VBUS)
unnamed: C14.1, R18.2, U2.1 (VDD)
unnamed: C17.2, U3.1 (BOOT)
unnamed: C21.1, R25.1, U3.6 (COMP)
unnamed: C17.1, D1.2, L1.1, U3.8 (PH)
unnamed: C20.1, U3.4 (SS)
unnamed: R21.2, R24.1, U3.5 (VSENSE)

Notes on the sheet:
Power Out
Power In
+3V3 Buck
Power Indicator

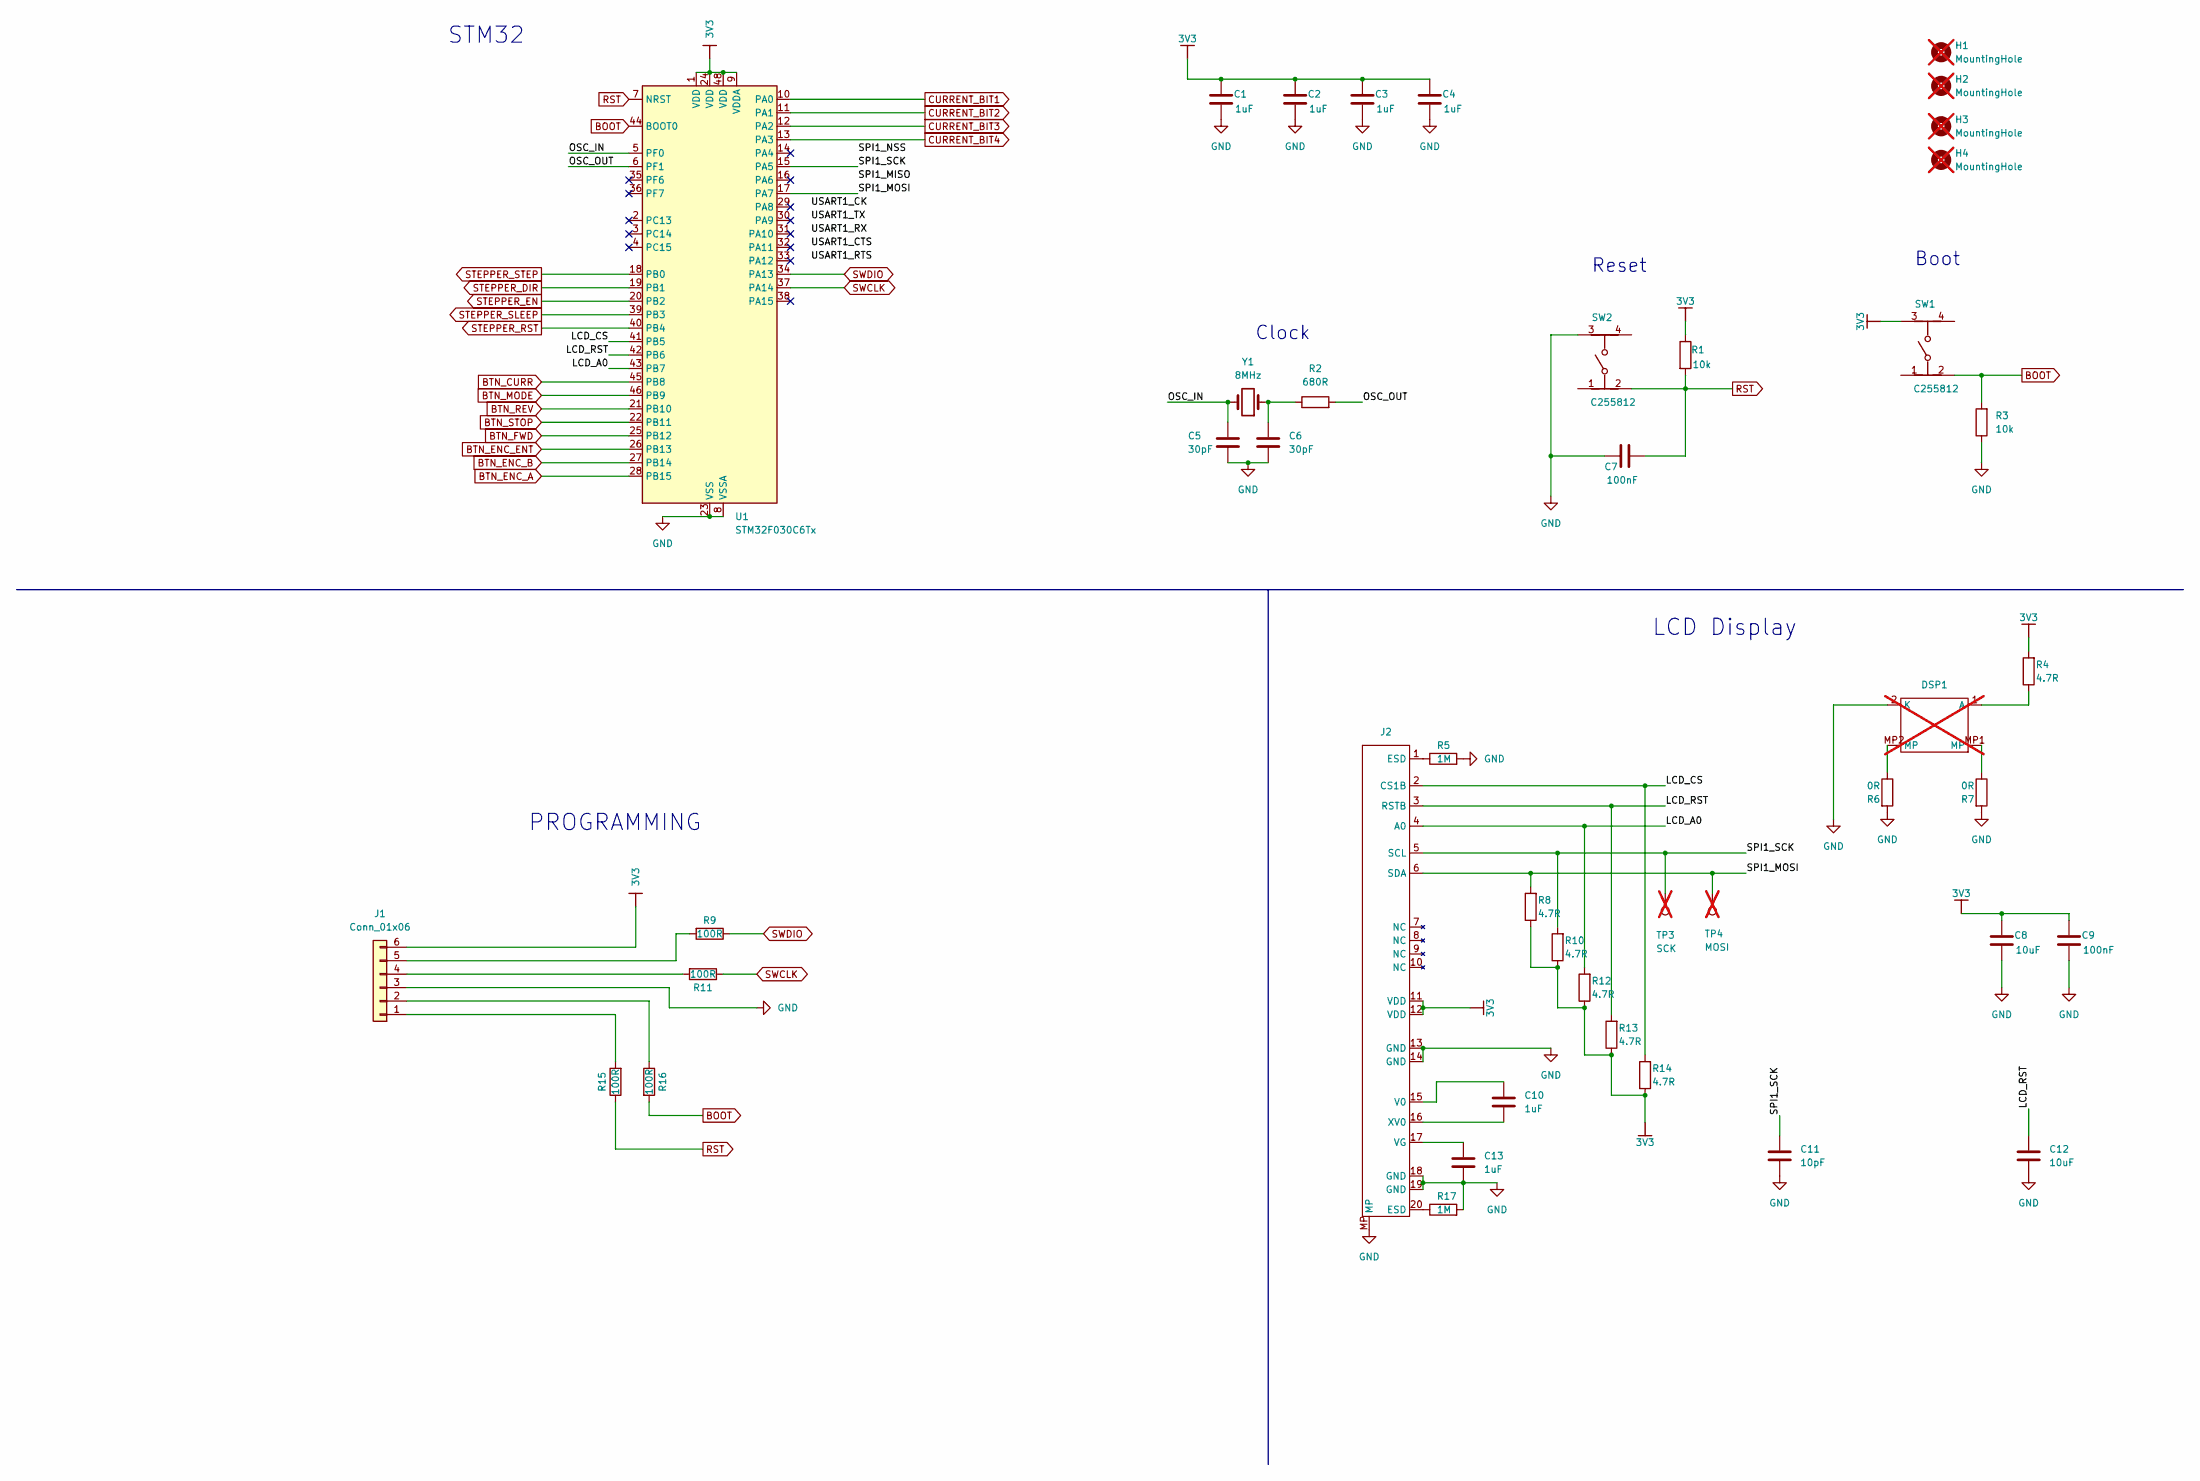
[picture p10: schematic MCU.kicad_sch]

Parts:
C1, C2, C3, C4, C10, C13: 1uF; C_0603_1608Metric
C5, C6: 30pF; C_0603_1608Metric
C7, C9: 100nF; C_0603_1608Metric
C8, C12: 10uF; C_1206_3216Metric
C11: 10pF; C_0603_1608Metric
DSP1: HS12864G19C Display; not fitted
H1, H2, H3, H4: MountingHole; MountingHole_3.2mm_M3; not fitted
J1: Conn_01x06; PinHeader_1x06_P2.54mm_Vertical; LCSC C37208
J2: AFC01-S20FFC-00; LCSC C262274
R1, R3: 10k; R_0603_1608Metric
R2: 680R; R_0603_1608Metric
R4, R8, R10, R12, R13, R14: 4.7R; R_0603_1608Metric
R5, R17: 1M; R_0603_1608Metric
R6, R7: 0R; R_0603_1608Metric
R9, R11, R15, R16: 100R; R_0603_1608Metric
SW1, SW2: C255812; FSM2J_1; VOLTAGE RATING DC 24V; MANUFACTURER PART NUMBER FSM2JSMAA; MOUSER DESCRIPTION Tactile Switches TACTILE 260G FORCE S
TP3: SCK; TestPoint_Pad_D2.0mm; not fitted
TP4: MOSI; TestPoint_Pad_D2.0mm; not fitted
U1: STM32F030C6Tx; LQFP-48_7x7mm_P0.5mm; LCSC C62514
Y1: 8MHz; Crystal_SMD_HC49-SD; LCSC C12674

Connections:
3V3: C1.1, C2.1, C3.1, C4.1, C8.1, C9.1, J1.6, J2.11 (VDD), J2.12 (VDD), R1.1, R4.2, R8.1, R10.1, R12.1, R13.1, R14.1, SW1.3, U1.1 (VDD), U1.9 (VDDA), U1.24 (VDD), U1.48 (VDD); also elsewhere on the board
/MCU/LCD_A0: J2.4 (A0), R12.2, U1.43 (PB7)
/MCU/LCD_CS: J2.2 (CS1B), R14.2, U1.41 (PB5)
/MCU/LCD_RST: C12.1, J2.3 (RSTB), R13.2, U1.42 (PB6)
/MCU/OSC_IN: C5.2, U1.5 (PF0), Y1.2
/MCU/OSC_OUT: R2.2, U1.6 (PF1)
/MCU/SPI1_MOSI: J2.6 (SDA), R8.2, TP4.1, U1.17 (PA7)
/MCU/SPI1_SCK: C11.1, J2.5 (SCL), R10.2, TP3.1, U1.15 (PA5)
BOOT: R3.2, R16.2, SW1.2, U1.44 (BOOT0)
BTN_CURR: U1.45 (PB8); also elsewhere on the board
BTN_ENC_A: U1.28 (PB15); also elsewhere on the board
BTN_ENC_B: U1.27 (PB14); also elsewhere on the board
BTN_ENC_ENT: U1.26 (PB13); also elsewhere on the board
BTN_FWD: U1.25 (PB12); also elsewhere on the board
BTN_MODE: U1.46 (PB9); also elsewhere on the board
BTN_REV: U1.21 (PB10); also elsewhere on the board
BTN_STOP: U1.22 (PB11); also elsewhere on the board
CURRENT_BIT1: U1.10 (PA0); also elsewhere on the board
CURRENT_BIT2: U1.11 (PA1); also elsewhere on the board
CURRENT_BIT3: U1.12 (PA2); also elsewhere on the board
CURRENT_BIT4: U1.13 (PA3); also elsewhere on the board
GND: C1.2, C2.2, C3.2, C4.2, C5.1, C6.1, C7.1, C8.2, C9.2, C11.2, C12.2, C13.2, DSP1.2 (K), J1.3, J2.13 (GND), J2.14 (GND), J2.18 (GND), J2.19 (GND), J2.MP, R3.1, R5.2, R6.2, R7.2, R17.2, SW2.3, U1.8 (VSSA), U1.23 (VSS), U1.47 (VSS); also elsewhere on the board
unnamed: C6.2, R2.1, Y1.1
unnamed: DSP1.1 (A), R4.1
unnamed: DSP1.MP1 (MP), R7.1
unnamed: DSP1.MP2 (MP), R6.1
unnamed: J1.1, R15.2
unnamed: J1.2, R16.1
unnamed: J1.4, R11.2
unnamed: J1.5, R9.2
unnamed: J2.1 (ESD), R5.1
unnamed: J2.20 (ESD), R17.1
unnamed: C10.1, J2.15 (V0)
unnamed: C13.1, J2.17 (VG)
unnamed: C10.2, J2.16 (XV0)
RST: C7.2, R1.2, R15.1, SW2.2, U1.7 (NRST)
STEPPER_DIR: U1.19 (PB1); also elsewhere on the board
STEPPER_EN: U1.20 (PB2); also elsewhere on the board
STEPPER_RST: U1.40 (PB4); also elsewhere on the board
STEPPER_SLEEP: U1.39 (PB3); also elsewhere on the board
STEPPER_STEP: U1.18 (PB0); also elsewhere on the board
SWCLK: R11.1, U1.37 (PA14)
SWDIO: R9.1, U1.34 (PA13)

Notes on the sheet:
Reset
Clock
Boot
LCD Display
STM32
PROGRAMMING

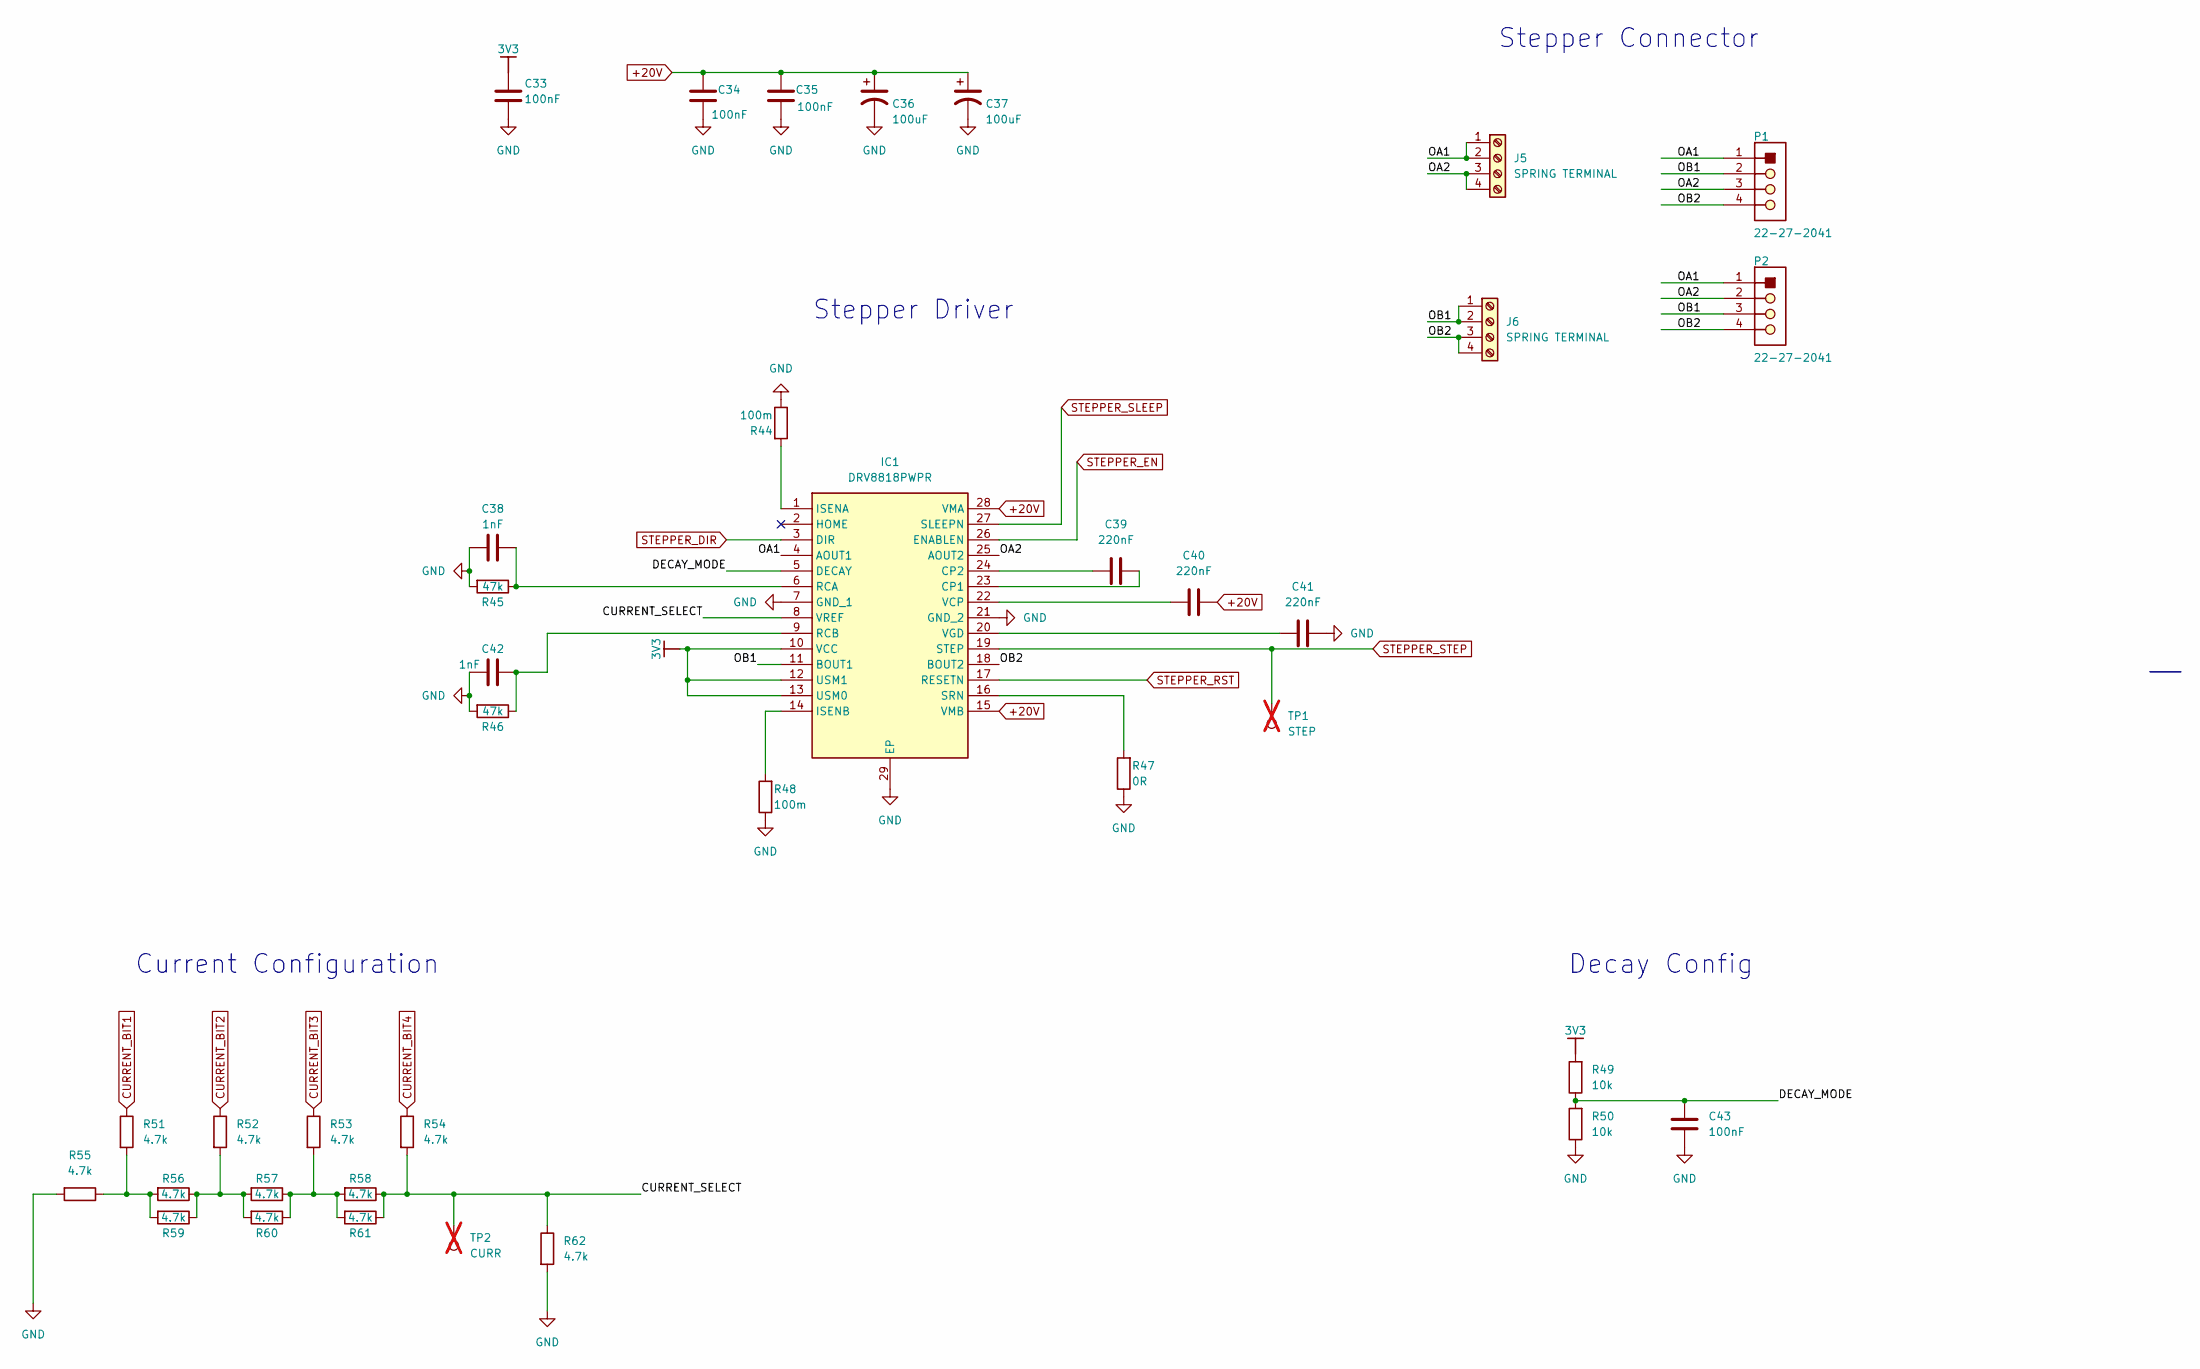
[picture p11: schematic Stepper.kicad_sch]

Parts:
C33, C34, C35, C43: 100nF; C_0603_1608Metric
C36, C37: 100uF; CP_Elec_8x10; LCSC C176665
C38, C42: 1nF; C_0603_1608Metric
C39, C40, C41: 220nF; C_0603_1608Metric
IC1: DRV8818PWPR; SOP65P640X120-29N; Mouser Part Number 595-DRV8818PWPR
J5, J6: SPRING TERMINAL; MX235-5.0-04P; LCSC C5349564
P1, P2: 22-27-2041; Molex_KK-254_AE-6410-04A_1x04_P2.54mm_Vertical; VOLTAGE RATING 250V; CURRENT RATING 4A; LCSC C239364
R44, R48: 100m; R_1206_3216Metric
R45, R46: 47k; R_0603_1608Metric
R47: 0R; R_0603_1608Metric
R49, R50: 10k; R_0603_1608Metric
R51, R52, R53, R54, R55, R56, R57, R58, R59, R60, R61, R62: 4.7k; R_0603_1608Metric
TP1: STEP; TestPoint_Pad_D2.0mm; not fitted
TP2: CURR; TestPoint_Pad_D2.0mm; not fitted

Connections:
3V3: C33.1, IC1.10 (VCC), IC1.12 (USM1), IC1.13 (USM0), R49.2; also elsewhere on the board
+20V: C34.1, C35.1, C36.1, C37.1, C40.2, IC1.15 (VMB), IC1.28 (VMA); also elsewhere on the board
/Stepper/CURRENT_SELECT: IC1.8 (VREF), R54.2, R58.1, R61.1, R62.1, TP2.1
/Stepper/DECAY_MODE: C43.1, IC1.5 (DECAY), R49.1, R50.2
/Stepper/OA1: IC1.4 (AOUT1), J5.1, J5.2, P1.1, P2.1
/Stepper/OA2: IC1.25 (AOUT2), J5.3, J5.4, P1.3, P2.2
/Stepper/OB1: IC1.11 (BOUT1), J6.1, J6.2, P1.2, P2.3
/Stepper/OB2: IC1.18 (BOUT2), J6.3, J6.4, P1.4, P2.4
CURRENT_BIT1: R51.1; also elsewhere on the board
CURRENT_BIT2: R52.1; also elsewhere on the board
CURRENT_BIT3: R53.1; also elsewhere on the board
CURRENT_BIT4: R54.1; also elsewhere on the board
GND: C33.2, C34.2, C35.2, C36.2, C37.2, C38.1, C41.2, C42.1, C43.2, IC1.7 (GND_1), IC1.21 (GND_2), IC1.29 (EP), R44.1, R45.2, R46.2, R47.1, R48.1, R50.1, R55.2, R62.2; also elsewhere on the board
unnamed: C39.2, IC1.23 (CP1)
unnamed: C39.1, IC1.24 (CP2)
unnamed: IC1.1 (ISENA), R44.2
unnamed: IC1.14 (ISENB), R48.2
unnamed: C38.2, IC1.6 (RCA), R45.1
unnamed: C42.2, IC1.9 (RCB), R46.1
unnamed: IC1.16 (SRN), R47.2
unnamed: C40.1, IC1.22 (VCP)
unnamed: C41.1, IC1.20 (VGD)
unnamed: R51.2, R55.1, R56.2, R59.2
unnamed: R52.2, R56.1, R57.2, R59.1, R60.2
unnamed: R53.2, R57.1, R58.2, R60.1, R61.2
STEPPER_DIR: IC1.3 (DIR); also elsewhere on the board
STEPPER_EN: IC1.26 (ENABLEN); also elsewhere on the board
STEPPER_RST: IC1.17 (RESETN); also elsewhere on the board
STEPPER_SLEEP: IC1.27 (SLEEPN); also elsewhere on the board
STEPPER_STEP: IC1.19 (STEP), TP1.1; also elsewhere on the board

Notes on the sheet:
Current Configuration
Stepper Connector
Stepper Driver
Decay Config

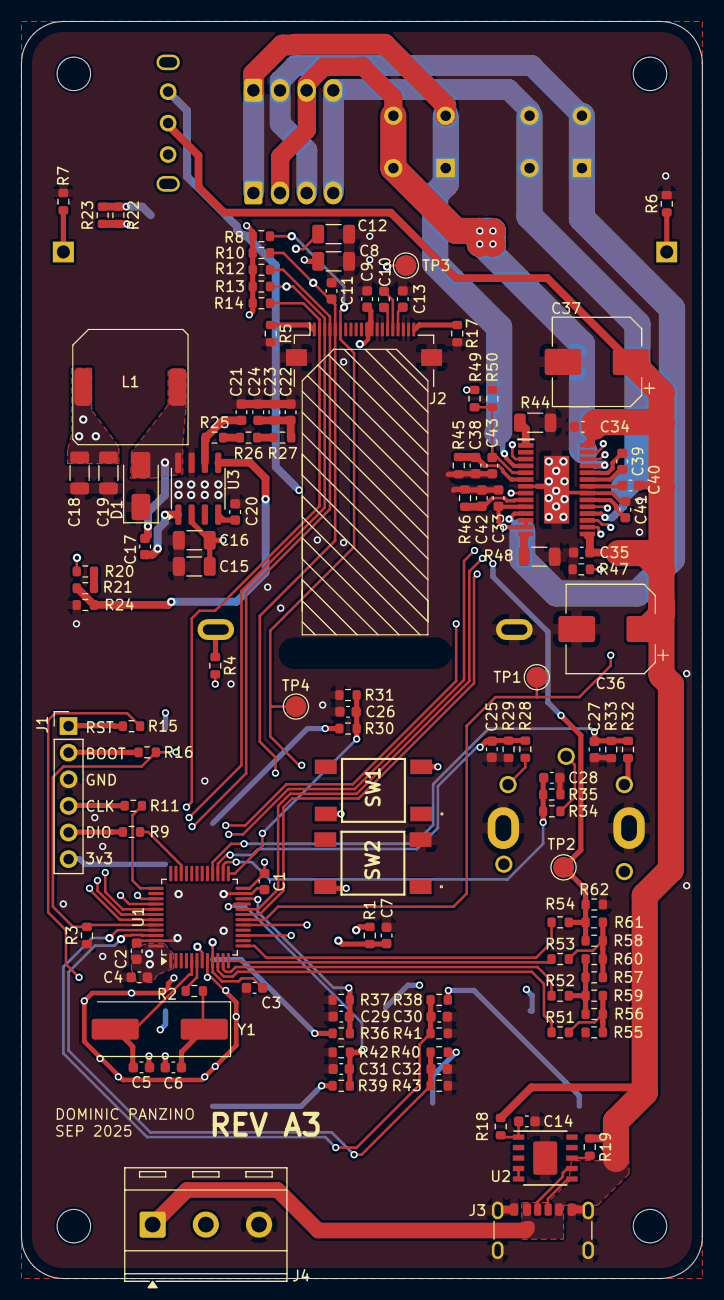
[picture p12: board StepperControllerPCB.kicad_pcb from above]

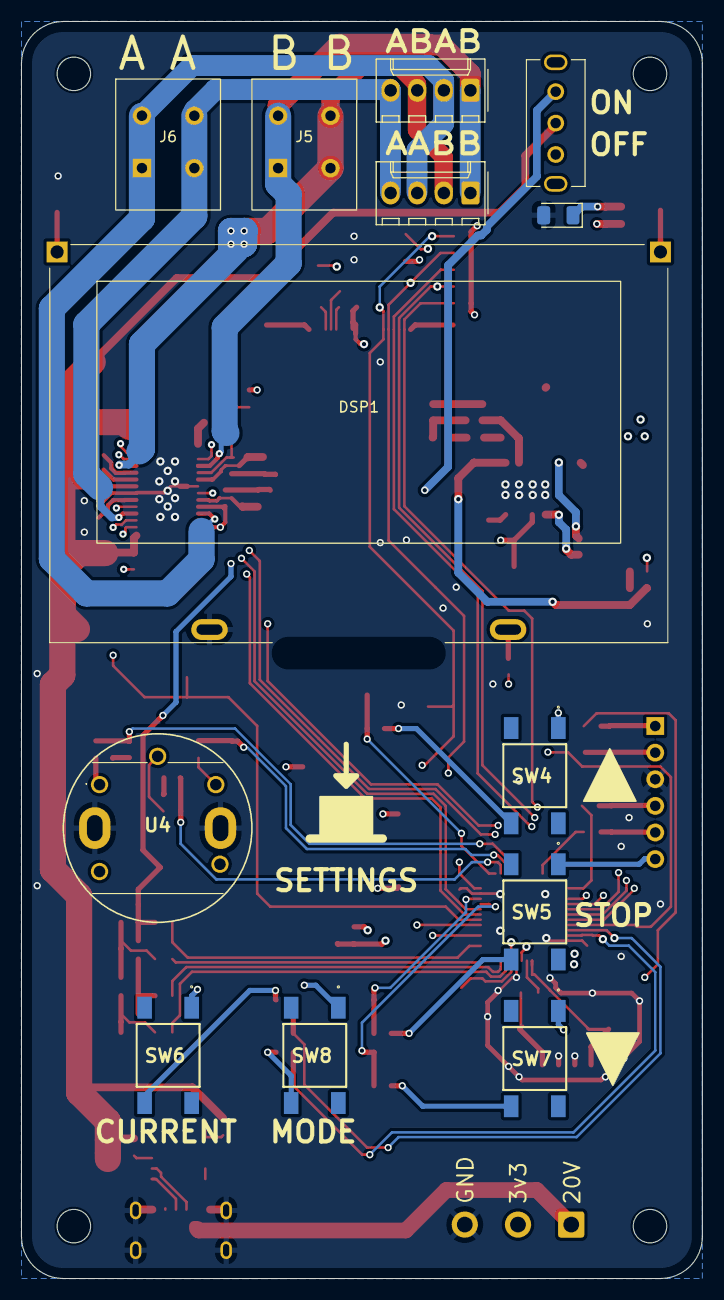
[picture p13: board StepperControllerPCB.kicad_pcb from below]

Board: 4 copper layers, 65.0 x 120.0 mm, 139 parts (13 on the bottom side), 86 nets.
