Hennnnnnryyyy/StepperController/Firmware/STM32 Firmware/STM32Firmware/Core/Inc/main.h

#define CurrentBit1_Pin GPIO_PIN_0
#define CurrentBit1_GPIO_Port GPIOA
#define CurrentBit2_Pin GPIO_PIN_1
#define CurrentBit2_GPIO_Port GPIOA
#define CurrentBit3_Pin GPIO_PIN_2
#define CurrentBit3_GPIO_Port GPIOA
#define CurrentBit4_Pin GPIO_PIN_3
#define CurrentBit4_GPIO_Port GPIOA
#define StepperStep_Pin GPIO_PIN_0
#define StepperStep_GPIO_Port GPIOB
#define StepperDir_Pin GPIO_PIN_1
#define StepperDir_GPIO_Port GPIOB
#define StepperEn_Pin GPIO_PIN_2
#define StepperEn_GPIO_Port GPIOB
#define RevBtn_Pin GPIO_PIN_10
#define RevBtn_GPIO_Port GPIOB
#define StopBtn_Pin GPIO_PIN_11
#define StopBtn_GPIO_Port GPIOB
#define FwdBtn_Pin GPIO_PIN_12
#define FwdBtn_GPIO_Port GPIOB
#define EncBtn_Pin GPIO_PIN_13
#define EncBtn_GPIO_Port GPIOB
#define EncB_Pin GPIO_PIN_14
#define EncB_GPIO_Port GPIOB
#define StepperSleep_Pin GPIO_PIN_3
#define StepperSleep_GPIO_Port GPIOB
#define StepperRst_Pin GPIO_PIN_4
#define StepperRst_GPIO_Port GPIOB
#define LCDcs_Pin GPIO_PIN_5
#define LCDcs_GPIO_Port GPIOB
#define LCDrst_Pin GPIO_PIN_6
#define LCDrst_GPIO_Port GPIOB
#define LCDa0_Pin GPIO_PIN_7
#define LCDa0_GPIO_Port GPIOB
#define CurrBtn_Pin GPIO_PIN_8
#define CurrBtn_GPIO_Port GPIOB
#define ModeBtn_Pin GPIO_PIN_9
#define ModeBtn_GPIO_Port GPIOB
