Hennnnnnryyyy/StepperController/(commit log)

2025-08-11 Creat KiCad folder
2025-08-11 Adding initial KiCAD files.
    [Buttons.kicad_sch, ESP32.kicad_sch, Power.kicad_sch, Stepper.kicad_sch, StepperControllerPCB.kicad_pcb, StepperControllerPCB.kicad_sch]
2025-08-20 Initial PCB draft
    [Buttons.kicad_sch, EC12D1524403.PcbLib, EC12D1524403.SchLib, EC12D1524403.stp, EDI2CAP.CFG, ESP32.kicad_sch, Power.kicad_sch, Stepper.kicad_sch]
2025-09-03 New PCB design
    [Bill of Materials-StepperController.csv, Buttons.kicad_sch, EC12D1524403.stp, EDI2CAP.CFG, Housing.step, Knob.step, MCU.kicad_sch, Pick Place for StepperController_PCB.csv]
2025-09-03 Added name silkscreen
    [StepperControllerPCB.kicad_pcb]
2025-09-20 purchased board
    [Buttons.kicad_sch, MCU.kicad_sch, Power.kicad_sch, Stepper.kicad_sch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]
2025-11-26 STM32 Firmware
