Hennnnnnryyyy/StepperController/(notices)

Notices in the files:
Firmware/STM32 Firmware/STM32Firmware/Core/Inc/main.h:
Copyright (c) 2025 STMicroelectronics.
All rights reserved.
This software is licensed under terms that can be found in the LICENSE file
